Starr1y/FPGA/docs/README.md

# 文档入口

本轮当前文档：[V14接线与操作](V14接线与操作.md)、[三分钟拍摄脚本](三分钟演示拍摄脚本.md)、[任务书对照](任务书对照_20261102.md)、[版本清理与恢复](版本清理与恢复.md)。

原任务依据为[2026-09-23整理稿](任务书_20260923历史整理.md)。其他DUO/FAN/UI23等文档为历史研发记录，保留原文；其旧路径对应清理前标签，不代表当前工作树工程入口。硬件参考、字体许可、用户设计资料保留。
