Starr1y/FPGA/使用说明.md

# 当前版本使用说明

当前唯一FPGA入口是[fpga/current](fpga/current/README.md)，左MPU6050、右BNO085，按钮发声。

请先阅读[V14接线与操作](docs/V14接线与操作.md)，注意**归中后还须从快捷菜单启动演奏**。默认音量8/256，音量80尚待新构建。

历史版本和恢复方法见[清理记录](docs/版本清理与恢复.md)；上位机保留在`host/`。
