Starr1y/FPGA/docs/版本清理与恢复.md

# 版本清理与恢复（2026-11-02）

## 保留与归档原则

- 当前唯一入口：`fpga/current/`，精确归档已交付V14，源码和位流一一对应。没有把待改的默认音量80混入旧位流。
- 保留`experiments/2026-10-29-GEST26-stable/`全部内容，286个文件逐个SHA256核对未变；该基线为历史不同传感器/击发模式，不能当V14插线直接替换。
- 上位机2.7.2 ZIP从旧GEST27发布目录迁到`host/`，Git blob与SHA256不变；保留源代码所在包。
- `docs/`硬件参考、任务依据、CAD/设计资料和第三方许可保留。早期研发文档仍在原位，其源码链接按清理前标签读取。
- 原开发副本、桌面发布目录和本地未提交时序实验未清理；本次仅在独立发布副本中操作。

## 从当前工作树移除的旧内容

共2406个原跟踪路径从旧位置移除（其中上位机ZIP迁移，部分源码在当前工程重新归档）。具体以本次Git diff为准。

| 旧入口 | 原因和去向 |
| --- | --- |
| `fpga/`下旧FAN、DUO01/02/03、IO22、UI23、原始音频/观测组件、旧reports/impl与GEST27 ZIP | 当前工程自带完整依赖，多个旧入口容易误烧；全部原始内容仍在清理前标签，未重写历史 |
| `board-test/`旧版证据 | 旧报告不能当V14证据；V14证据置于`fpga/current/validation`和`reports`，旧证据由标签恢复 |
| `piano-tail-fix-20261008/` | 旧独立迭代归档到历史 |
| 2026-10-17 MOUSE1.4、2026-10-18 LIVE2.0/2.1实验快照 | 重复工程、旧上位机及运行环境不再堆放主工作树；历史可恢复 |

没有强推、删除历史提交或删除远端历史标签。此清理降低当前工作树的混乱，**不会让完整Git历史自动变小**。新电脑只取当前工作树可用浅克隆；需要历史时再fetch相应标签。

## 精确恢复

清理前提交：`e16aaf42515aa47f3d8796b693c2edb623edec7a`。

清理前标签：`archive/pre-v14-cleanup-20261102`。GitHub查看：[完整旧树](https://github.com/Starr1y/FPGA/tree/archive/pre-v14-cleanup-20261102)。

推荐在独立目录克隆该标签，避免覆盖当前工作目录：

```powershell
git clone --branch archive/pre-v14-cleanup-20261102 --single-branch https://github.com/Starr1y/FPGA.git FPGA-before-v14
```

需要某个旧文件时，在该旧树中定位并复制即可；不要在有未提交改动的当前工程上执行整树恢复。原有`gest26-stable-baseline`标签保持原样。

## 本轮验证口径

当前输入/位流/证据的校验工具为`tools/verify_current_release.py`，便携回归入口为`tools/run_current_regressions.py`。新回归结果另存，不覆盖冻结的原始validation。实板声音、方向、双手及量化验收仍按任务对照表推进。
