Starr1y/FPGA/docs/当前任务书执行与验收.md

# 当前任务书执行与验收

更新：2026-10-17。此文按当前 `C:/Users/10324/Desktop/TangLab/TangLab` 核对，不沿用 9 月旧工程的实现状态。

## 范围和用户最新决定

完整目标为双手自主读取、演奏控制、音频合成、本机显示与实机测量。原始任务依据为 [2026-09-23 整理的任务书](任务书_20260923历史整理.md)，其中“现状”是历史记录，不代表当前进度。

用户后续决定优先打通实际 IMU 操控 HDMI，采用 I²C；选音恢复为相对基准方向前方 180°，不循环，取消距离选音。击发改为模块 Z 轴负向线性加速度 **或** 负向急动度。中文界面、英文唱名、按键切换诊断页、宽松归中和手持操作保留。双手、发声及任务书指标继续在完整范围内，当前静音单手 UI 不能作为整机完成证据。

## 工作包审计

### DUO02 与外部控制开发

独立 [DUO02](DUO02_立体声与音效接入.md) 已将 32 Voice 按两手分配到独立左右混音，接入延迟、分数合唱、简化混响和效果后静音渐变。8/32 Voice 加默认混响至实际串行 DAC 的数字检查通过；32 Voice 场景 3034 个采样、6066 个串行字、最大合成 369 周期、无欠载或效果丢样。14 张 RTL 画面、三键模式/湿声与新状态提示检查通过。两路 100 Hz 原生行为传感器、50 MHz/48 kHz 板卡数字链路已通过，解码 83449 个串行字，验证独立归中、负 Z 和弦/旋律、启用混响、静音渐变和停用隔离。首次布线报 PR0004/0 未布通，没有产生时序或位流；保存失败证据后，算法 1 重建成功，setup/hold 零违例，Fmax 50.026/26.542 MHz，Logic 35.8%、BSRAM 74、DSP 83，已冻结本版本。核心余量非常小；没有实物声音/双手/长期负载证据。

[外部控制输入逻辑和参数菜单](外部编码器踏板与腕部按键逻辑.md)已实现编码器 2/4 边沿定位、踏板和两只腕部按钮的同步/消抖/松键事件，接入音色/尾音/效果/湿声/延迟/反馈等参数控制。原始输入到菜单及菜单边界/所有权检查通过。独立中文菜单绘制与 50/25 MHz 帧快照联动通过数字检查、综合为 0 DSP/4 BSRAM；尚未分配板卡引脚或接入主工程 TMDS，不能将数字检查视为物理踏板、编码器和腕部按钮已完成。

### 菜单到音频参数接入

[菜单到实际音频参数接入](菜单到音频参数接入.md)已新增独立核心：单一菜单参数源连接真实合成器、可调音效和 PT8211，复用现有传感器队列握手；音色/尾音只作用于后续音符，效果调参先降低湿声再提交。32 个不同音高同时活动、最大菜单混响反馈/湿声及动态表情的数字检查通过。尚未接入 DUO02 的外部引脚、IMU 和 HDMI 顶层，没有新位流或实物验证。

### DUO03 整机数字验证已冻结

[工程与操作](DUO03_统一控制与菜单接入.md)：板载键、编码器、踏板和腕部按钮共用一份参数，菜单已接入双 IMU、32 Voice、可调立体声和三页显示。KEY0＋KEY1 短按打开菜单。

六项数字/构建检查全部通过，包括原始按键到 RGB、双 I²C 至 PT8211、8/32 Voice 和 13 张 RTL 画面。Logic 35.9%、BSRAM 80、DSP 83，setup/hold 零违例、Fmax 50.861/29.724 MHz。下载文件为 `fpga/bitstream/tanglab_duo03.fs`，清单为 `board-test/duo03/firmware.json`；尚未下载或实物验证。

返回后先按[单手验证顺序](DUO03_返回后单手验证.md)核对启动来源、版本、静音和归中，再测负 Z 击发。[实机延迟工具](实机延迟记录与离线验收.md)和空白模板已提供；七项合成数据检查不代表实测 ≤10 ms。

### 波形、频谱与 Voice 观测开发核心

[FPGA 内音频观测](FPGA音频波形与频谱采集.md)已实现真实 PCM 的 1024 点双声道 FFT、64 列波形极值、64×2 频段及 32 Voice 元数据整帧缓冲。实际 32 Voice/混响/DAC 路径采样核对、两时钟像素读回和过载/复位检查通过。组合组件未布局综合为 Register 2000、LUT 1666、BSRAM 11、MULTALU27X18 2。

**尚未加入当前下载位流或绘制中文观测页**，没有整机新增时序或实物频谱结论。DUO03 保持原哈希，下一步接观测页面和实际 Voice 总线；WS2812、原生多分辨率与实测继续保留在完整任务范围。

### DUO01 板卡集成进度（数字验证已冻结）

已新增独立 `fpga/duo01/` 工程，双 I²C 引脚按 NEO Rev1.4 原理图逐点核对，板端采用开漏输出；接入双手扇区页面、物理按键命名、32 Voice 和 PT8211 数字输出。原 FAN04 源码及冻结位流保持原样。

首轮时序问题已修正：新版 setup/hold 违例为零，核心/像素 Fmax 50.123/27.371 MHz；Logic 48365、Register 21500、BSRAM 40、DSP 71。本版本使用有界音符查表、映射寄存器及力度事件缓冲；2048 个映射向量、8/32 Voice、按键与画面检查通过。50 MHz/48 kHz 原生完整数字链路已通过，两个 100 Hz 行为 IMU 完成独立归中、负 Z 和弦/旋律击发、静音渐变及单手停用隔离；解码 PT8211 的 83449 个串行字，其中 8136 个非零。位流及源码哈希已冻结；未下载或做模拟音频实测。核心时序余量较小，冻结与实板验收分别处理。

[独立双声道音效模块](双声道音效开发与验证.md)已通过旁路、延迟、分数合唱、四抽头混响、33000 个满尺寸 RAM 样本与清除/复位/削波检查；综合确认 32 BSRAM。尚未接入 DUO01，也不代表音效整机验收通过。

| DUO01 新增项 | 已完成的软件 | 当前验收范围 |
| --- | --- | --- |
| 双手板卡适配 | 两路独立 I²C、各自启停/原点/布局/表情，原理图球位与排针追踪 | 两颗模块与板端电气实测待完成 |
| 板端控制 | 物理 KEY1/KEY2 命名修正，组合键释放检测、去抖、当前手操作 | 按键仿真通过，实际操作待验证 |
| 双扇区 UI | 同屏两手、7/5/12 布局、独立击发提示、隐藏诊断、文楷字距 | RTL 模拟画面检查；显示器实拍待验证 |
| DAC 与 32 Voice | 50 MHz 核心、48 kHz 16 位混音复制左右、默认静音、渐入渐出 | 时序门槛和原生完整数字链路通过；没有模拟输出证据 |
| 完整任务 | 新代码保留前方 180° 角度选区及负 Z 加速度 OR 急动度 | 踏板/编码器/腕部键、效果/立体声、教学 LED、量化实测仍待完成 |

| 工作包 | 当前证据 | 仍需完成或验证 |
| --- | --- | --- |
| T0 实板基线 | 已有用户确认的 I²C 在线、姿态和下拍；Gowin C 版器件/时钟/引脚报告。FAN03 数字构建和位流已发布；历史 JTAG 枚举记录 | 新击发版本下载、接线/轴方向照片、模块带载电压；实际音频输出、时钟及外部测点记录。用户确认 IMU 未连接并延后实测；历史 UI 能用不证明新位流已经上板 |
| T1 自主传感器读取 | FPGA I²C 主机、SHTP Set/Get Feature、四元数与加速度/角速度解析，实际时间戳；双手核心隔离检查及 DUO01 双总线板卡适配代码 | 真实两手报告率、丢包、断连与拔掉 PC 后持续运行仍待实测。当前 `AUTONOMOUS_SPI` 为历史参数名，FAN 构建实际调用 I²C 主机 |
| T2 演奏控制 | 每手相对归中、7/5/12 音区、180° 非循环、3° 滞回、越界/陈旧/跳变保护；负 Z 击发、力度、Roll 八度与表情；DUO01 双手 UI/当前手按键代码 | 触发阈值、报告间隔与表情手感需真人验证；踏板、编码器、腕部按键及实际镜像佩戴仍待完成。按键切换和弦模式不代表物理踏板已实现 |
| T3 音频 | 32 Voice、ADSR、四个音色预设、Release、DUO01 板载 PT8211 代码与时序；独立延迟/分数合唱/简化混响模块通过仿真和综合 | DUO02 已接入独立左右混音及三类音效，8/32 Voice 与原生 DAC 数字链路检查通过；外部菜单到真实音频链路的独立数字检查已通过；DUO03 已接板卡顶层并完成数字回归与位流冻结；模拟输出与实板最大负载验收待完成。FAN04 冻结顶层继续保持静音 |
| T4 本机显示与教学 | DUO01 双扇区、7/5/12 布局、独立预选/击发、演奏/诊断两页、帧快照 CDC、640×480 安全区域，8 张 RTL 模拟画面通过 | 独立中文菜单与原始编码器/按钮到 50/25 MHz 帧快照已通过数字验证，DUO03 已完成主工程三页显示接入及 13 张光栅检查；实板双手页面、物理踏板/编码器、真实 PCM 波形/FFT 与 Voice 元数据、像素帧缓冲已完成组件级验证；中文绘制页和整机接入、WS2812 曲目与节拍待完成；显示器缩放不代表原生多分辨率或 EDID 协商 |
| T5 测量与交付 | 独立版本、源码/位流哈希、数字检查、资源与时序报告、中文操作说明 | 每手真人识别率/误触发、10 分钟漂移、1000 次外部动作至模拟音频延迟、32 路谱峰与逐路静音、最大负载 2 小时日志、两手结构接线与完整演示包 |

## 量化目标的证据要求

| 项目 | 完成条件 | 当前状态 |
| --- | --- | --- |
| 七区稳定 | 每区中心 30 秒不跳区；边界往返 20 次无抖动 | 数字边界检查存在；实物原始记录缺失 |
| 漂移 | 固定 10 分钟，相对 Yaw ≤5°或不跨区 | 实物记录缺失 |
| 击发识别 | 每人每手 100 次，识别率 ≥98%；非击打 100 次误触发 ≤2 次 | 仅有数字逻辑测试与用户功能反馈；不能给出真人识别率 |
| 基础复音 | ≥4 独立 Voice 重叠，实际动作/和弦触发 | DUO02 数字混音及串行 DAC 记录已完成；真实动作和模拟输出待测，FAN04 保持静音 |
| 32 Voice | 32 个独立频率与状态，逐路静音 | DUO02 的 32 Voice 数字检查已通过；实板频谱、逐路静音及整机音频验收待完成 |
| 三类表情 | 力度只改音量，Roll 改音高，Pitch 改音色明暗；3～10 Hz 手颤单列 | FAN04 数字检查覆盖 100/200 Hz 滤波与元数据异常保护；真人与声学验证未完成 |
| ≤10 ms 延迟 | ≥1000 次外部动作参考至 DAC 模拟输出，报告全部样本与最大值 | 缺实际动作参考/模拟输出波形；数字仿真次数不能替代 |
| 满负载 2 小时 | 32 Voice＋效果＋HDMI＋双手通信，无欠载/卡死，记录削波/复位 | 整机连续实验缺失 |

## 当前推进顺序

1. FAN03 已将负 Z 加速度/负 Z 急动度做成独立 OR，15 项仿真、34 种 RTL 画面及构建通过；Logic 12.4%，建立/保持违例零。待用户返回后下载并进行真人下拍标定。
2. FAN04 已对齐 100 Hz 报告和滤波，数字检查覆盖 3～10 Hz 手颤、慢 Roll、Pitch，以及松键保持与掉线安全；等待真实 IMU 验证。
3. [双手 I²C 开发核心](双手I2C核心与事件所有权.md)已通过 4 项数字仿真，具备各自归中、表情、事件队列和取消所有权；DUO01 已完成板卡引脚/开漏适配及双手 UI；先验证单颗健康 IMU，再验证真实两手，后续接踏板/编码器/腕部按钮。
4. [双手数字音频核心](双手数字音频集成与验证.md)已接入双 I²C 开发链路，完整音区映射、和弦模式及组释放有数字证据；DUO02 已接入效果与独立立体声并冻结位流；DUO03 已连接外部控制和主工程菜单并完成数字冻结，下一步做实板声音及延迟验收。
5. 保存真实动作/模拟音频测点、全部统计及长时日志，逐项验收后冻结版本。

任何阶段都以当前源码和该版本证据为准。任务书完整目标仍未完成，数字检查或一次成功下拍不能代替双手脱机演奏和全量实机验收。
