Starr1y/FPGA/docs/DUO03_返回后单手验证.md

# DUO03 返回后单手验证

2026-10-17。本表为空白实测计划，尚未执行下载或测试。先只接一颗健康 IMU，右手留空且不使能。

## 先确认上电时会运行哪个程序

SRAM 下载在 FPGA 掉电后会丢失；再次上电可能运行 Flash 中的旧程序。旧 SPI/UART 与本版 I²C 的引脚用途不同。因此，不能按“先 SRAM 下载→整体断电接线→上电”就假定仍在运行 DUO03。

1. IMU 和新增外部信号先保持断开，板卡单独连接电脑。核对下载文件 `fpga/bitstream/tanglab_duo03.fs` 与发布清单，不选临时 `impl/` 文件。
2. 单板 SRAM 下载后核对 HDMI **DUO03**，两手“待使能”、静音。先用板载键验证菜单、诊断和焦点；这一步不接传感器。
3. 在接入模块前，确认冷启动来源：采用经核对的仅 JTAG 启动方式，确保配置前相关引脚状态适合接入；或经明确选择将已验证的本版写入正确启动 Flash，再以模块断开状态冷启动核对。具体模式、开关和 Flash 操作需根据实际板卡与下载器确认。本次没有改启动开关或写入 Flash。
4. 启动来源确认之后才整体断电接线。不要通过带电插拔保持 SRAM 内容。若尚不能确认冷启动程序，先停在单板 UI 检查，回来后再核对启动方式。

手动启停只是已配置逻辑对输出的门控；不是 PGOOD、限流或配置前/掉电隔离。D14/D15/F15 留空，不能用 D15 接 3V3 绕过检测。以下步骤不能消除缺少隔离时电源松动造成的反向供电风险。

## 接一颗模块，保持静音

在已核对的启动条件下，整体断电连接手 0：SCL→E19/J13.38，SDA→C18/J13.40，INT→E16/J13.28，RST→D20/J13.36。VCC 接实际测得的 3.3 V，GND 共地；PS1、PS0、ADO、CS 接模块共地节点，地址 0x4A。J13.11 是 5 V，不能作 3.3 V。具体排针追踪见[DUO01 接线](DUO01_双手板卡接入与操作.md)。

所有组合键都应一起按下、全部松开；上电先松开所有键。短按建议 80～200 ms。第一次只使用板载键，不要求外接按钮。

| 顺序 | 操作与预期 | 实测记录 |
| --- | --- | --- |
| 1 | 上电核对 DUO03、两手未使能、焦点左手、静音；检查模块供电与温升 | 待填写 |
| 2 | KEY1＋KEY2 长按约两秒再全部松开；只启动左手 | 待填写 |
| 3 | KEY1＋KEY2 短按切到诊断；左手 PKT 增长，姿态随转动改变 | 待填写 |
| 4 | 面向演奏正前方，稍稳后短按 KEY0；记录归中耗时及精度，不要求手持绝对静止 | 待填写 |
| 5 | 短按 KEY1＋KEY2 回演奏；左右慢转验证前方 180° 七区和越界保护 | 待填写 |
| 6 | +Z 朝上，沿本体 −Z 下拍一次；观察品红闪光、上次音符和击发数，回位后再拍 | 待填写 |
| 7 | 分别只旋转、向上、慢平移、静止；记录误击发与跳区 | 待填写 |
| 8 | KEY0 长按约 1.5 秒换为 5/12 区；KEY2 短按只切焦点，右手仍未使能 | 待填写 |

击发条件沿用负 Z 去重力加速度 ≤−2.5 m/s² **或**负向急动度 ≤−80 m/s³，另有数据新鲜度、归中、可用音区、回位和防连击门槛。向上动作的减速也可能产生负 Z；按实际波形和误击发记录调整，不能靠动作名称判断。这里的“负 Z”是模块本体轴，不是任意姿态下的房间竖直向下。

## 菜单与声音分开验证

KEY0＋KEY1 短按打开/关闭菜单；菜单内 KEY1 下一项/增加、KEY2 上一项/减少，KEY0 确认/退出编辑，KEY0 长按返回。菜单内不使用单键短按归中或换手；先关菜单再做演奏操作。

| 检查 | 操作与预期 | 记录 |
| --- | --- | --- |
| 参数共用 | 菜单改左手音色，回主页面显示同值；主页面 KEY1 短按后菜单也更新 | 待填写 |
| 显示分层 | 主页面只保留演奏信息；诊断显示姿态/通信；菜单显示请求值、生效音效和过渡状态 | 待填写 |
| 表情 | 主页面 KEY1 按住至少 300 ms，慢 Roll/Pitch，松开结束；菜单打开时不触发表情 | 待填写 |
| 低音量试音 | 以上静音检查通过后，低音量接耳机/输出，KEY0＋KEY2 长按两秒解除静音；左手仅左声道 | 待填写 |
| 新音符参数 | 改音色/尾音后再下拍，新音符采用新值，旧尾音不突然换音色 | 待填写 |
| 音效过渡 | 菜单调音效、延迟、湿声等；观察“过渡中→已生效”，听是否爆音或卡顿 | 待填写 |
| 停用与复位 | 主页面 KEY2 长按约 1.5 秒复位当前手，需重新归中；KEY1＋KEY2 长按启停 | 待填写 |

六个外部输入可继续留空。准备测试编码器/踏板/腕部键时，按[DUO03 输入表](DUO03_统一控制与菜单接入.md)断电连接无源触点，共地 J13.12，不能输入 5 V。双手和模拟音频延迟、识别率、漂移、两小时负载另行验收；参见[任务审计](当前任务书执行与验收.md)与[延迟记录](实机延迟记录与离线验收.md)。
