Starr1y/FPGA/docs/任务书_20260923历史整理.md

# 凌空双奏：FPGA 双手姿态感知虚拟乐器任务书

**整理日期：**2026-09-23  
**目标依据：**《基于FPGA的双手姿态感知虚拟乐器_技术评审与任务材料清单(1).docx》（V1.0，2026-09-13）  
**现状依据：**桌面 `C:\Users\10324\Desktop\TangLab_test\TangLab` 中的 RTL、测试平台、Gowin 报告、固件清单及交付记录。  
**状态口径：**“已实现”指当前源码存在相应逻辑；“仿真记录”指项目交付文档记载通过，但本次未重新运行仿真；“已生成位流”指目录中有原编译结果；“上板通过”必须有本轮实物数据。目标文档中的设计与指标均不自动算作已完成。

## 1. 项目目标与范围

制作一套以 **Tang Mega 138K 普通 Dock C 版**为实时主机的双手虚拟乐器。两只手的 BNO085 直接接入 FPGA：相对 Yaw 选择七音区，下拍触发音符，动作强度控制音量，Roll 控制击发八度、持续弯音和手颤，Pitch 控制音色明暗。踏板在“双旋律”和“左手和弦＋右手旋律”之间切换；旋转编码器在板上设置音色、尾音和效果。声音由 FPGA 逐样本合成并经 I²S 输出，HDMI/LED 显示演奏状态；PC 仅用于调试和记录，不参与正式演奏的实时闭环。

**基础验收目标：**双手交互、至少四个独立 Voice、ADSR 与混音、实时变调、无整段预录 PCM、动作到模拟音频输出的最大延迟 ≤10 ms（最终至少 1000 次）。  
**主要拓展目标：**32 个独立 Voice、力度/Roll/Pitch 三类可独立展示的声音表情、两类合成音色、FPGA 内音效、HDMI 视听反馈和脱机 LED 教学。≤5 ms、ESP-NOW、BLE/手机、录音回传是通过核心验收后再决定的冲刺项。

### 系统边界

- BNO085 可承担芯片内部采样与姿态融合；FPGA 负责 SHTP 报告处理、相对姿态、动作判定、Voice 调度、声音、效果和显示。不能把 BNO085 内部融合说成“全部由 FPGA 实现”。
- 有线正式演奏不依赖外置 MCU 或 PC。无线附件如实施，应与核心路径隔离。
- 所有“≤10 ms”“32 复音”等完成声明都需要对应的可重复实测或仿真证据；Gowin 时序报告只证明约束内的数字路径，不能代替整机延迟测量。

## 2. 工作包与完成定义

| 编号 | 工作包 | 主要工作 | 可交付成果与通过条件 |
| --- | --- | --- | --- |
| T0 | 实板基线 | 核对 C 版器件、50 MHz 时钟、3.3 V 接线；下载现有位流；验证串口握手、单/四声部 I²S 音频和单颗 BNO085 SPI | 固件版本与 SHA-256、接线照片、逻辑分析仪或示波器记录、实测问题清单；模拟结果单列 |
| T1 | 传感器自主读取 | 由 FPGA 完成 BNO085 复位、SHTP 初始化、Set/Get Feature、长度/通道/序号检查和四元数/加速度/角速度定点解析；再扩为双独立 SPI | 不借 PC 下发每次配置即可持续取得双手有效报告；记录报告率、丢包、错误和恢复状态 |
| T2 | 双手演奏控制 | 每手相对原点、七音区和滞回、下拍状态机、力度、Roll 八度锁存/弯音/手颤、Pitch 明暗、掉线安全；踏板与编码器去抖 | 断开 PC 后双手可选音、击发、切换模式与参数；单变量实验可分别证明三个声音表情 |
| T3 | 音频扩展 | 保留现有四 Voice DDS/ADSR 基础，加入 Note-On/组所有权/回收、和弦与 32 Voice；增加第二类 FM 或等价独立音色、可调 Release、延迟/合唱/简化混响 | 四 Voice 正常重叠；32 个独立频率与状态可逐路检查；最大负载无欠载、卡死或异常削波 |
| T4 | 本机显示与教学 | FPGA HDMI 显示音区、左右手、踏板模式、参数菜单、Voice、波形与频谱；WS2812 教学提示 | 拔掉 PC 后仍能演奏和设置；画面及 LED 与真实声音/状态一致 |
| T5 | 测量与交付 | 外部动作参考到 DAC 模拟输出的延迟测量；漂移、误触发、复音、断连及长时间运行；整理可复现交付包 | 保存原始数据、测点、统计、工具版本、稳定码流、演示脚本及开源引用记录 |

**依赖顺序：**T0 的实板基线 → T1 单手自主读取 → T2 单手最小演奏闭环 → T1/T2 双手扩展 → T3/T4 增强 → T5 全量验收。T3 中现有四 Voice 可与 T1 并行维护，但不能以 PC 手动配置四 Voice 代替“脱机姿态演奏”。

### 建议里程碑

原目标文档按两名队员、每人每周约 15～20 小时、八周实施作规划。下表是**从正式启动日重新计时的目标**，不是当前已完成周次。

| 阶段 | 里程碑 | 进入下一阶段的门槛 |
| --- | --- | --- |
| 第 1～2 周 | 单颗 BNO085 自主读取、实板音频、单手七区与下拍、四 Voice 最小闭环 | PC 断开后可由单手动作发声；报告率、丢包、初步延迟有实测记录 |
| 第 3～4 周 | 双 SPI 双手、踏板模式、力度/Roll/Pitch 表情、32 Voice 与两类音色 | 双手不串音；旧 Voice 在踏板切换时不跳音；三表情可分别展示；32 路有独立证据 |
| 第 5～6 周 | FPGA 效果、HDMI 菜单/波形/频谱、LED 教学；视核心进度决定无线/手机 | 完整原型脱离 PC 可演奏；效果和显示不引起音频欠载 |
| 第 7～8 周 | 1000 次延迟与动作统计、最大负载和 2 小时稳定运行、版本冻结、演示与复现资料 | 只演示有证据的稳定功能；冻结后变更须重做相关回归 |

## 3. 关键量化验收

| 项目 | 目标文档给出的验收条件 | 当前是否已有证据 |
| --- | --- | --- |
| 单手七音区 | 每区中心 30 秒不跳区，边界往返 20 次无抖动 | 无实物数据 |
| 姿态长期稳定 | 固定 10 分钟，相对 Yaw ≤5°或始终不跨区 | 无实物数据 |
| 下拍识别 | 每人每手 100 次，识别率 ≥98%；非击打共 100 次，误触发 ≤2 次 | 尚无动作识别 RTL |
| 基础复音 | ≥4 个独立 Voice 同时发声，正常双手/和弦演奏可触发 | 四 Voice 音频 RTL 与仿真记录有；姿态演奏未完成 |
| 拓展复音 | 32 个独立 Voice，32 个不同频率，可逐路静音并核对状态 | 尚无 32 Voice RTL |
| 三维表情 | 力度只改音量、慢 Roll 改持续音高、Pitch 改频谱明暗；手颤 3～10 Hz 单列验证 | 尚无对应动作和表达链路 |
| 有线端到端延迟 | 外部动作参考至 DAC 模拟输出，最终 ≥1000 次，最大值 ≤10 ms；异常样本不得删去 | 尚无整机测量 |
| 最大负载和稳定性 | 32 Voice＋效果＋HDMI＋通信无欠载；完整运行 2 小时 | 尚无整机测量 |

“≤5 ms”仅在同一完整方法的 1000 次最大值通过后申报。以上阈值来自目标文档，具体赛题口径仍需按正式竞赛文件核实。

## 4. 桌面 Gowin 工程目前完成了什么

### 4.1 已有源码与构建结果

| 子系统 | 当前可确认的实现 | 证据及边界 |
| --- | --- | --- |
| Gowin 工程 | `fpga/tanglab.gprj`、RTL、CST/SDC、`build.tcl` 齐全；目标器件 `GW5AST-LV138PG484AC1/I0` | 原 PnR 报告记录 Gowin **V1.9.12.03**、器件 C 版；这是 2026-09-21 的已有构建，本次未重新编译 |
| 位流与资源 | `fpga/bitstream/tanglab.fs` 已生成，SHA-256 为 `a017322bc3e3911c5d783eeaee1d2da0972148459151aa4514f112e2a067cbdf`；报告记录 9 BSRAM、3 DSP、Fmax 57.204 MHz | SHA-256 与 `board-test/固件清单.json` 一致；内部 50 MHz 时序报告不能说明板外接口或实板性能 |
| 四声部音频 | `audio_core.v` 有四套相位/频率/增益/ADSR 状态、正弦/锯齿/方波/三角波、饱和混音和削波计数；`i2s_output` 输出 16 位双声道同一混音，平均 48 kHz | `tb_audio.sv` 覆盖饱和、释音、I²S 移位；`docs/交付验证.txt` 记录仿真通过。尚无 32 Voice、FM、效果、立体声独立处理 |
| PC 串口与抓取 | `top.v` 连接 921600 baud UART、帧收发、配置命令、2048 点×5 通道抓取、预览与状态计数；`docs/协议与测量.md` 描述 CRC 和测量口径 | `tb_lab.sv` 与交付记录记载四声部 375/750/1125/1500 Hz 数字链路验证；本次未取得并重跑原始仿真日志 |
| IMU 传输 | `imu_transport.v` 可选择 RVC UART、SHTP UART 或单路 SPI Mode 3；实现复位/WAKE/CS/INT、原始包缓冲、长度限制、时间戳和错误计数 | `tb_imu.sv` 覆盖三种输入与 SPI 发送；这是**单个可切换传输端口**，不是双颗 BNO085 并行读取 |
| 上板准备 | 有 PMOD 接线指南、SPI 参数 JSON、固件清单及原编译报告 | `board-test/two-voice-spi.json` 的 1000 报告是**测试目标参数**，不是完成的测试结果 |

### 4.2 尚不能算完成的目标

1. **传感器自主控制与双手：**当前 `imu_transport.v` 注释明确写着“Report decoding and feature requests are on the PC”。RTL 未见 FPGA 内 SHTP 传感器报告解析、自动 Set/Get Feature、双独立 SPI、相对四元数或精度监控。
2. **姿态直接演奏：**未见 Yaw 七音区、归中/滞回、下拍判定、力度映射、Roll/Pitch 表情、声部组和弦、踏板或编码器输入。当前 Voice 主要通过 PC 串口命令配置，不能据此称为脱机双手乐器。
3. **拓展音视频：**未见 32 Voice、FM 引擎、延迟/合唱/混响、HDMI、WS2812 教学。PC 上的音频图表不能替代 FPGA 直出 HDMI。
4. **硬件验收：**目录中的 `docs/交付验证.txt` 与 `board-test/固件清单.json` 均明确记载实板音频/SPI、1000 条报告和端到端延迟未验证；也没有两手误触发、漂移或 2 小时运行数据。
5. **PC 软件范围：**交付记录提到 TangLab.exe 的模拟联调，但当前桌面 `TangLab` 文件夹不含 EXE 或 PC 源码，无法仅凭这个 Gowin 工程复现 GUI 结论。

**现阶段判断：**项目已完成“可构建的四声部数字音频＋单路 IMU 原始传输＋串口观测”技术底座，尚未形成目标文档要求的“BNO085 双手直连 FPGA、无需 PC 的姿态演奏闭环”。“已生成位流”与“实物已通过”必须分别陈述。

## 5. 下一轮优先任务与停止线

1. **先做现有固件的实板基线。**按项目指南核对板卡 C 版、时钟和引脚，先验证串口握手、声音输出，再验证单颗 BNO085 SPI；保存实际日志、听音结论和示波器/逻辑分析仪证据。任何失败先定位供电、时钟、引脚、协议与位流匹配。
2. **把 IMU 解析与配置从 PC 移入 FPGA。**先完成单颗 BNO085 的初始化、报告解析、报告率和异常恢复，再考虑复制为第二路；以“PC 断开后仍连续产生有效姿态/加速度缓存”为门槛。
3. **建立最小姿态发声闭环。**先用单手七音区＋下拍触发已有四 Voice，验证归中、滞回、误触发和数字注入至 I²S；之后增加第二手、踏板和表达控制。
4. **再扩大到 32 Voice 与显示效果。**每次扩展均保存独立谱峰、资源/时序和音频负载证据；音频稳定性优先于视觉效果、无线和手机功能。

**停止线：**若单颗 BNO085 无法稳定输出所需报告、长线 SPI 持续丢包、板级音频/时钟未确认，或数字注入到 DAC 路径不可测，就先修这些问题，不开始外壳、无线和手机功能。

## 6. 最终交付清单

- 完整 HDL、约束、构建脚本、工具版本、仿真向量、稳定位流、资源与时序报告。
- 两手接线与结构图、SHTP 子集/错误处理说明、踏板与编码器状态图、参数表。
- 延迟原始波形与统计、漂移/识别率/误触发/复音/最大负载/断连/2 小时运行报告。
- 脱机演奏操作说明、五分钟现场演示脚本、答辩材料和故障处理卡。
- 外部参考资料和实际复用文件的许可证/修改记录。

## 7. 证据索引

- 目标任务及指标：随附 Word 文档第 1～44 节，尤其第 26～27 节赛题对照、第 37～41 节排期与量化验收。
- 当前 RTL：`C:\Users\10324\Desktop\TangLab_test\TangLab\fpga\rtl\audio_core.v`、`imu_transport.v`、`top.v`；仿真平台在 `fpga\tb\`。
- 当前构建：`fpga\reports\pnr\tanglab.rpt.txt`、`tanglab_tr_content.html`、`board-test\固件清单.json`。
- 当前验证口径：`docs\交付验证.txt`、`docs\协议与测量.md`、`两声部与SPI上板测试指南.txt`。
