Starr1y/FPGA/fpga/releases/2026-11-04-mpu33-host335/project/duo04-key30-linkfix331/验证记录.md

实际验证（非实物）
tb_linkfix331: TB_PASS old75 periodic reset reproduced,new75 200Hz>1s stable,no timeout widening,bus failure retained,68 DATA_RDY timeout retained
tb_who75_33: TB_PASS all256 identity values:68/75 accepted,other254 rejected
tb_linkfix331_pins: TB_PASS real I2C START/repeatedSTART/ACK14bytes:WHO75 noDRDY+68 standard,200Hz schedule,bus disconnect isolation,failure register capture
GUI故障6/寄存器/自动复位计数可见，最终EXE本地模拟AI、PDF、外部JSON及模拟曲谱上传通过。
身份枚举256项，68/75允许，其他254项拒绝。WHO75无DATA_RDY模型对照旧版周期复位，新版持续200Hz；WHO68正常采样及断流保护通过。真实I2C引脚级双模块、断开隔离和故障寄存器锁存通过。
总线引擎、融合、音色、演奏与显示源码逐字节保持3.3；本轮仅采样调度、设备后缀和故障上下文修改。
未综合布线烧录，未使用真实设备。
