Starr1y/FPGA/host/README.md

# TangLab上位机2.7.2

本包从清理前仓库`fpga/GEST27-routefix2-20261031/TangLab-2.7.2-Windows-x64.zip`原样迁移，没有重新打包或替换用户配置。

SHA256：`1389024f1d3fef7bd8fda3f9e4fd1c77a2a3cfe18b47f0dff2256f65407ec7fa`。Git blob仍为`83d8dcaddff8799d55567d013ce55d80ff46478e`。

包内含Windows便携程序和源码；按包内README启动，AI识别API密钥在本机配置，不写入仓库。此为已有2.7.2版本，不宣称已完整支持V14新增MPU诊断字段或已完成图片到实板教学验收。

演奏闭环不需要上位机；首版图片简谱转换和导入允许电脑参与。当前FPGA见[工程入口](../fpga/current/README.md)。
