Starr1y/FPGA/fpga/current/README.md

# V14：MPU Y轴指向选区（冻结发布）

本目录为已交付 V14 的源码和位流归档，未修改默认音量或传感器类型；左 MPU6050、右 BNO085，两个外接低有效按钮各自发声。

## 构建与文件

打开 `tanglab_duo04_score27_routefix2.gprj`；顶层 `top_duo04`。Gowin **V1.9.12.03**，器件 **GW5AST-LV138PG484AC1/I0 / GW5AST-138C**。在本目录执行 `gw_sh build_selected.tcl`，实际调用冻结的 `build_yforward_v14.tcl`，Route2、timing-driven，保持原CST/SDC。

`INPUT_MANIFEST.json`保留构建当时的输入哈希；其中少量旧名字的脚本/测试是冻结输入，正常构建只使用上述入口。不要为了清理名称修改冻结输入。重建会产生新的impl；Gowin授权与安装需本机配置，不分发许可证。

发布位流：`bitstream/MPU_LEFT_YFORWARD_V14_TIMING_PASS.fs`。

SHA256：`8ba0470c1df1ac357156439d23122be474c355b1ec2593f43e918f5ec9bfebdb`。

完整构建耗时1687.234秒；Setup +0.029ns、Hold +0.164ns、0违规端点、0未布通网络。PR1014告警保留，余量小，不据此宣称任意环境稳定。

原始报告从`impl/`映射到`reports/`；原始`.vg`压缩保存于`reports/synthesis-netlist.zip`，不分发巨大中间布局数据库。原始证据JSON中的绝对路径是历史构建位置，不是当前电脑的依赖。`RELEASE_MANIFEST.json`标明归档文件和路径映射，根目录验证工具核对哈希及关键证据。

## 功能边界

- 左路以MPU物理+Y轴的水平指向选音；当前竖装定义为+X近似向上。Y轴朝天/朝地时水平航向无定义。
- KEY0会重新执行现有零偏/姿态归中，完成后的第一帧水平朝向为零点，应对应FA。需要转180°是待查异常，操作不应要求半圈反转。
- 七音区每区约25.714°，FA名义边界±12.875°，不是20°一音；5/12音布局按原代码保留。
- MPU无磁力计，水平航向仍可能漂移；本模块WHO=0x75兼容为已验证寄存器和采样行为的实验兼容，不声明芯片身份或绝对精度。
- 按钮10ms消抖，一次按下一次击发；运动不发声。必须在线、归中、数据新鲜且角度在有效范围内，整机还须启动演奏。
- 默认音量8/256，用户要求的默认80是下一版待办；不能把改后的源码配给此旧位流。
- 显示1024×600，像素49MHz，H总1312（48/96/144），V总624（3/10/11），约59.85186Hz，负极性同步；逻辑UI640×480映射并旋转180°。
- 右路仍为BNO085；双MPU不是本版配置。声音、方向、实际双手及长时间运行尚未完成本轮验收。

操作及完整排查见[接线指南](../../docs/V14接线与操作.md)。
