Starr1y/FPGA/fpga/releases/2026-11-04-mpu33-host335/project/duo04-key30-linkfix331/README.md

TangLab 3.3.1 周期性采集掉线修复

本版独立于原3.3工程。保留3.3两档轻重音、S1/S2、V14风格HDMI、四音色、32复音、和弦、波形和AI曲谱教学；不使用V14双手采集后端或Lite裁剪。

修复内容：WHO_AM_I=0x75的实验兼容模式按配置的200Hz定时读取原始寄存器，不依赖可能不兼容的DATA_RDY位；WHO=0x68保持原标准状态位轮询。40ms采集保护、I2C错误处理和严格配置读回不放宽。其余身份值仍拒绝。0x75并不证明模块型号，量程/数据布局仍须实物确认。
时间戳仍表示FPGA读出/计算完成时刻，不证明传感器内部数据一定新鲜；无DATA_RDY兼容读取无法仅靠相同数值判断传感器是否停止更新。真实IMU波形与运动需要上板核验。
最近故障寄存器已锁存，重新初始化不会覆盖。上位机演奏页每手直接显示采集在线/离线、故障码、寄存器、I2C错误数、自动复位次数和姿态年龄。

接线沿用3.3（不接INT）：
左SCL J13.38/E19，SDA J13.40/C18，S1 J13.25/D15，S2 J13.28/E16。
右SCL J13.37/D19，SDA J13.39/C19，S1 J13.26/D14，S2 J13.31/E17。
两颗GY-521分别接独立I2C，AD0均GND，XDA/XCL/INT不接。按键另一端接GND；模块/总线使用核实兼容的3.3V供电和逻辑，共地。

编译：打开tanglab_duo04_key30_linkfix331.gprj，顶层top_duo04。必须重新综合，然后重新布局布线；旧fs不含修复。impl中的process_config.json是必要IDE配置。核心50MHz、音频48kHz不变。
本轮没有运行综合、布局布线或下载，没有新的fs。上位机设备名应带L331。只有软件更换不改变板上采集。

测试步骤：
1. 重新编译并检查新报告，下载新fs后打开本目录TangLab.exe连接实际串口。
2. 先输出静音，切换手柄来源；保持静止，等偏置/归中准备，再对已连接手归中。不要求两手同时在线。
3. 连续观察至少60秒：采集是否仍循环离线，自动复位和I2C错误是否持续增加。归中移动前先静止，之后缓慢转动确认角度实际变化。
4. 若仍掉线，记录两次故障间隔、故障码、寄存器、复位/I2C计数、正在使用的fs文件名。码2表示总线事务失败，4身份拒绝，5配置读回不一致，6采样超时。最近故障可保留历史，需结合当前在线状态和计数是否增加判断。
5. 之后低音量试S1/S2、和弦与波形，确认运动确实被更新，不能仅以“在线”判定采集正确。

已知时序限制：原3.3报告有238个setup违例端点、hold违例0，最差-4.292ns路径位于显示状态跨时钟域。本修复没有更改/放宽约束，也没有宣称解决该时序问题；必须用新报告重新检查零未布通、setup/hold及PR1014。
本次只在DATA_RDY不兼容的模型下复现了旧版周期复位，不是已取得实物掉线原因。若新版仍不稳定，应按新诊断定位总线、配置、数据更新或时序问题，不继续盲目放宽超时。
