Starr1y/FPGA/docs/任务书对照_20261102.md

# 任务书对照与未完成项（2026-11-02，V14）

## 对照依据及判定方式

依据仓库[2026-09-23任务书整理稿](任务书_20260923历史整理.md)及其引用的V1.0技术评审任务材料。原始Word原件本轮未找到，因此这是对现有整理稿的逐项技术核查，不宣称已核对新的正式竞赛文件。

历史[执行与验收](当前任务书执行与验收.md)更新于10月17日，含过时的源码现状；其“尚无32Voice”等旧结论不能直接套用V14。这里以V14源码、冻结仿真、完整PNR/STA与本次用户反馈分别判定。未重新运行的历史测试会标明。

用户后续变更：接口改I²C；左传感器改MPU6050、右仍BNO085；IMU只选音，外接按钮击发；显示1024×600；图片简谱教学首版允许电脑参与、无需板端Flash存谱。原任务中的SPI、动作击发、力度、完全脱机教学不能因此直接算通过，需作为变更/降级向验收方说明。

## T0～T5逐项状态

| 工作包 | 当前可确认 | 尚未完成/需补证据 |
| --- | --- | --- |
| T0 实板基线 | V14完整工程/位流、哈希、Gowin版本、引脚、完整STA；用户报告左MPU可在线、可归中，按钮接地故障修复且可拉低 | **模拟声音闭环未确认，当前仍报告无声**；实际下载文件与运行状态留证、接线照片、串口诊断、示波器/逻辑分析仪波形 |
| T1 自主传感器 | FPGA直连左MPU原始六轴→定点融合；右BNO自主初始化/报告路径保留；引脚级MPU仿真通过，异常恢复有数字测试 | 左MPU+右BNO实际同时工作/各自拔插恢复未形成记录；报告率/错误率、10分钟/2小时数据缺失；WHO=0x75兼容不能证明芯片身份；**当前不是双MPU** |
| T2 选音与演奏控制 | 相对方向、7/5/12区、3°滞回、30ms确认；外接按钮10ms消抖和单次击发，掉线/过期禁止；方向与按钮仿真通过 | **用户仍反馈归中后需转180°、SOL/LA区域体感偏窄**；按钮低电平到真实声音尚未打通；双手不串音和手持误触发待测。当前按钮力度固定96，原任务的动作力度表达未实现为本版交互；物理踏板输入顶层接常量，不能称踏板已接入 |
| T3 合成与音频 | 32Voice架构、ADSR、四音色、独立左右混音、延迟/合唱/混响、板载PT8211与标准I²S路径保留 | 当前V14板载/外接DAC实际发声、至少4Voice叠奏、32个独立谱峰/逐路静音、音效和最大负载无欠载均缺实板证明；旧数字记录不是本轮完整32声部验收 |
| T4 HDMI与教学 | 实际工程为1024×600、49MHz、约59.852Hz，UI旋转180°；菜单/归中诊断/逐音等待教学及RAM曲谱存储存在；原上位机2.7.2包含AI曲谱功能 | 屏幕持续无闪烁、朝向/字体可读性尚缺最终验收；图片→识别→人工校对→导入→跟弹全链路未留本轮记录；**WS2812教学未接入当前顶层**；当前HDMI顶层未接入完整实时PCM波形/FFT/Voice观测页；无EDID自动协商/多分辨率选择 |
| T5 测量与交付 | 已有冻结源码/位流/报告/测试哈希；本次补三分钟脚本、接线说明、版本恢复和任务对照 | 真人选区/漂移、1000次端到端延迟、≥4/32复音、双手断线恢复、2小时负载、最终演示原片与完整接线照片均待完成 |

## 指标是否已达标

| 指标 | 要求 | V14结论 |
| --- | --- | --- |
| 七区稳定 | 每区中心30秒不跳；边界往返20次 | 未实测；每区名义约25.714°，不是20°，须先排查方向与估算误差 |
| 长期漂移 | 固定10分钟，Yaw≤5°或不跨区 | 未实测；MPU无磁力计，不能承诺航向长期无漂移 |
| 原动作识别 | 每人每手100次≥98%，非击打100次误触≤2 | 当前交互改为按钮，不具备原动作击发验收证据；应申请变更或后续恢复单独实现 |
| 按钮可靠性 | 按一次一个事件、按住不连发、松开重置 | 数字测试已覆盖；实板建议每手100次并记录漏发/多发，不冒充原动作指标 |
| 基础复音 | ≥4独立Voice重叠 | 架构具备，实板待验证 |
| 32Voice | 32不同频率、独立状态、逐路静音 | 历史数字证据存在；V14完整实板证据缺失 |
| 三类表情 | 力度、Roll持续音高、Pitch明暗；3～10Hz颤音 | 代码有部分映射/效果；本版按钮固定力度，完整三类未实测，不算通过 |
| 端到端延迟 | 外部动作参考→DAC模拟输出，≥1000次最大≤10ms | 未实测。按钮路径自身10ms消抖，还叠加按键板RC及音频延迟；若以物理按下计时，存在超过10ms目标的风险，不能用50MHz STA证明达标 |
| 2小时满载 | 双通信+32Voice+效果+HDMI无欠载/卡死 | 未执行连续实板实验 |
| 教学 | 原文包括脱机LED教学；后续首版为PC参与图片简谱跟弹 | RAM导入/逐音教学有代码；端到端实板待验收，WS2812/断电保谱不是本版完成项；后者已被用户移出首版范围 |

## 当前优先级

1. **先闭环声音**：确认快捷菜单启动→按键事件计数→Voice活动→非零PCM→DAC/耳机输出。当前低电平与音量调整不足以证明事件已到音频。
2. **修方向与区域手感**：记录归中前后Y轴方向、原始/过滤Yaw、选区和校准状态；先复现180°问题，再核查角度缩放/安装轴定义。不能简单整体加180°掩盖。
3. **完成默认音量80的新构建**：当前归档V14默认8；源码、位流、哈希和STA必须作为一个新版本更新，不能只改README称已完成。
4. **下一版双手MPU**：用户已确认下一版改为左/右均MPU6050，并将默认音量设为80。需重新配置、编译和验证两路独立归中、选音、按钮与掉线隔离；本次上传的V14仍是左MPU+右BNO，不使用旧位流冒充双MPU。
5. **可拍演示及教学**：声音/方向过关后，完成两音色、短句、逐音教学，再按三分钟脚本拍摄；AI转换先核对结果再导入。
6. **量化验收**：七区/漂移→≥4Voice→32Voice/音效→1000次延迟→2小时满载，保留全部原始数据。原10ms目标需先确认是否接受按钮模式及其计时起点，必要时优化消抖并重做回归。

## 本次交付边界

本次归档保持V14冻结功能，没有新增双MPU、音量80、动作击发、无漂移或“已修复无声”的声明。上传和仓库清理不是新硬件验收。清理前冻结成果可从标签恢复，详见[版本清理与恢复](版本清理与恢复.md)。
