Starr1y/FPGA/docs/DUO01_单手返回测试表.md

# DUO01 单手返回测试表

本表用于新版通过构建发布门槛之后的实板验证。现在还没有执行这些测试；不要把表中的预期现象当作实测结果。

## 准备

单颗健康模块按 [DUO01 接线表](DUO01_双手板卡接入与操作.md)接手 0。先确认冻结清单和下载文件，HDMI 标记应为 DUO01。上电选左手、左右 IMU 未使能、静音；右手本轮保持未使能。

## 功能顺序

| 步骤 | 操作 | 预期现象 | 实测记录 |
| --- | --- | --- | --- |
| 1 | 左手焦点下长按 KEY1＋KEY2 两秒，全部松开 | 左手开始初始化并在线；右手不启动，声音静音 | 待填写 |
| 2 | 短按 KEY1＋KEY2，再全部松开 | 打开诊断页；左手 PKT 增长，姿态随转动变化 | 待填写 |
| 3 | 面向中间，尽量静止，短按 KEY0 并松开 | 归中结束，偏航接近零，精度满足击发要求 | 待填写 |
| 4 | 返回演奏页，缓慢水平转向左/右 | 青色预选依次变化，七音为 DO RE MI FA SOL LA SI | 待填写 |
| 5 | 转到前方 180° 之外，再回到中间 | 越界时禁止击发；回到范围并静稳后恢复 | 待填写 |
| 6 | 保持朝向，在当前音区做一次模块负 Z 下拍 | 对应扇区短暂品红，上次音符及击发数更新 | 待填写 |
| 7 | 只缓慢转腕、停住或向上抬起 | 不应仅靠转腕触发；向上动作的减速阶段仍可能有负 Z 加速度，需记录动作波形再判断 | 待填写 |
| 8 | 长按 KEY0 ≥1.5 秒再松开 | 七音→五音→十二半音；布局改变不保留旧击发闪光 | 待填写 |
| 9 | 按住 KEY1 ≥300 ms，慢 Roll/Pitch，松开 | 表情状态变化；松开保持弯音/明亮度，颤音停止 | 待填写 |
| 10 | 短按 KEY2 切到右手，再切回 | 只改变当前控制焦点；左手在线和原点不被清除 | 待填写 |
| 11 | 左手焦点下长按 KEY2 ≥1.5 秒再松开 | 只复位左手、需重新归中；不遗留品红击发提示 | 待填写 |

基准方向对应 FA 的七音中心；七区中心约为 −77.1°、−51.4°、−25.7°、0°、25.7°、51.4°、77.1°。边界有约 3° 滞回，跨边界后要再转一点才换区。前方范围以按 KEY0 时的方向为准。

击发检测使用去重力后的模块自身 Z 轴：`az ≤ −2.5 m/s²` 或 `jz ≤ −80 m/s³`，不是任意动作有加速度就触发。每次下拍后回到静稳状态再做下一次，至少留出 100 ms 防连击时间。模块装反或倾斜时，本体 −Z 与房间向下可能不同。

## 发声测试另行进行

以上静音 UI 验证通过后，再使用 KEY0＋KEY2 长按两秒切换发声；先低音量验证耳机/板载音频输出。软件默认 16 位混音复制左右，四个音色按 KEY1 短按切换。数字串行输出通过不等于模拟声音已经正常。

诊断页通信计数与 HZ 为十六进制，HIT 为十进制。记录固件哈希、接线照片、各步画面、异常动作及声音现象；完整任务书中的真人识别率、十分钟漂移和端到端延迟应另建原始数据记录。
