Starr1y/FPGA/fpga/releases/2026-11-04-mpu33-host335/host/数字教学使用说明.txt

TangLab 3.3.5 上传曲目数字教学

1. 关闭旧上位机，运行本目录TangLab.exe。连接原33/3.3.1固件；本版不需要重新烧录。
2. 第04页导入/AI转换→检查转换格式→上传；使用七音布局。含半音的十二音曲目不能用本次数字段映射，不会静默替换音符。
3. 下方先点停止；来源选择“键盘数字／鼠标教学测试”；点“选择导入曲目与来源（先停止）”；再点开始。
4. 点页面空白处，移开下拉框/输入框焦点，开启Num Lock。根据板上目标按数字：
   主键盘顶行1～7：左手DO RE MI FA SOL LA SI。
   数字小键盘1～7：右手DO RE MI FA SOL LA SI。
5. 数字直接选音并作答，不需要移动鼠标或再按S1。鼠标点击扇区仍可作答，走相同板上判题链路。
6. 弹对绿闪后等下一目标，再重新按数字。按错或错手仍送板卡判错，不由电脑代判。按住不连发，反馈期间不提前缓存下一题。
7. 暂停/继续保留进度；重来回第一题；停止结束教学。完成后不自动循环。

教学页数字自动启用，不依赖第01页“开启键盘演奏”或演奏模式选择。仅活动的第04页、电脑教学来源、正在运行的已上传曲目生效；编辑框打字/Ctrl快捷键不发音，暂停/停止/完成/真实IMU来源不发音。
教学自动使用目标音的C档，不按W/S换档，也不使用A/K表情或和弦。教学只支持逐音作答，不评节拍。
原第01页鼠标/数字两种演奏模式、纯轻音处理及W/S右手升降档保留。
该数字教学当前面向七音曲目；如果是五音/十二音布局，会明确提示使用七音。

验证：原演奏映射、教学双手1～7、Num Lock修饰符区分、按住不连发、暂停/反馈/在途判题/编辑焦点保护，以及最终EXE离线测试通过。协议检查确认使用原鼠标短按命令并等待板上计数变化，拒绝过期目标；真实板卡教学推进与声音待实测。
AI配置/曲谱协议及固件未改。本包无API密钥、用户曲库或会话令牌。
