Starr1y/FPGA/fpga/releases/2026-11-04-mpu33-host335/project/duo04-key30-linkfix331/协议变更.md

# KEY30协议增量
Hello载荷55字节，设备名DUO04-LIVE 2.1+GEST27+MPU6050+LITE29+KEY30。
虚拟输入继续使用76：手u8、S1/S2位掩码u8、Q4俯仰i16、保留u8。仅电脑来源有效，鼠标教学也走此输入；50直接击发返回不支持，避免绕过按键判定。
75表情配置仍为滑音左右掩码u8、颤音左右掩码u8、滑音ms u16。15/16/17/18本地菜单分别控制左右颤音/滑音。
真实/虚拟S1复用32位事件，kind=0起音、kind=1力度更新；力度仅改最新击发组且匹配事件ID/epoch。S2组合控制是否消费成连奏。
状态136保持496字节；原手势debug区每手7字节little-endian，bits55:52阻断码，51:44力度，43:42按键掩码，41长按，40组合，15:0音高偏移。0阻断=正常，1姿态/在线无效，2音区无效。事件140上传S1计数，不再上传加速度敲击作为发音事件。
整体采样、曲谱上传CRC协议不变。旧GUI只能读取部分兼容字段，新交互必须使用3.0。
