Starr1y/FPGA/fpga/releases/2026-11-04-mpu33-host335/host/source/score_assets/曲谱格式规范.md

# TangScore v1 曲谱格式

使用UTF-8的`.tangscore.json`，JSON Schema见同目录`tangscore.schema.json`；示例见两个曲谱文件。转换规则与可直接给AI的提示词见《给AI的转换提示词.txt》。2.7.1支持配置视觉AI后识别图片/PDF；不直接解析MIDI。识谱后的JSON仍须人工复核及校验。

你是曲谱转换器。把我提供的图片、PDF、MIDI内容或文字曲谱转换为TangScore v1。只返回一个纯JSON对象，不加Markdown代码围栏。不要编造看不清的音符，在warnings明确列出不确定的小节、声部或节奏；无法可靠辨认时请求更清晰来源，不输出虚假完整谱。
格式固定：format="tanglab.score"，version=1，title为1～64字符，tempo_bpm整数20～300，ticks_per_quarter=480，steps为1～2048个按演奏先后排序的对象。
每步：hand为left或right；midi为0～127整数（C4=60，C2=36，B5=83）；duration_ticks为1～30720整数；可选rest_before_ticks为0～30720整数。warnings可选字符串数组。禁止额外字段。
时值：四分音符480、八分240、十六分120、二分960、全音1920、附点四分720。连音延长应合并为一个音的总时值，休止写入下一步rest_before_ticks，不生成“休止音高”。拍号无需改变480基准。
首版是单手单音逐音等待，不支持同一步和弦或同时双手判题。和弦原谱必须提取明确主旋律，不把和弦拆成伪称同时演奏的连续步骤；在warnings说明省略的伴奏与和弦。双手交替可分别标注，遇同时声部选主旋律并警告。
正确处理谱号、调号、临时升降、八度记号；先保留原始实际MIDI音高。不要自行把半音改成自然音，不要擅自八度折叠。上位机会预览整曲八度移调/逐音八度折叠，由人确认后上传。超2048步应询问拆分段落，不静默截断。速度不明需在warnings标注采用的假设。
示例：{"format":"tanglab.score","version":1,"title":"两音练习","tempo_bpm":90,"ticks_per_quarter":480,"steps":[{"hand":"right","midi":60,"duration_ticks":480},{"hand":"left","midi":62,"duration_ticks":240,"rest_before_ticks":240}],"warnings":[]}
模型输出必须通过同目录tangscore.schema.json校验；AI不能代替谱面人工复核。

## 音域与布局
教学可表达MIDI36～83（C2～B5）。优先整曲移调整数个八度；无法整体放入时，逐音折叠整数个八度。界面逐项显示，任何变化都必须确认。默认自然音用七区，半音用十二区；五区仅容纳C、D、E、G、A，不会把F或B改成邻音。

## 时值与休止
当前是逐音等待，不做节拍评分。duration_ticks按速度换算为按键保持ms，板端范围100～10000ms，超范围会在预览提示并要求确认；自然衰减和释音仍单独作用，不等于全程等响。rest_before_ticks保存在电脑曲谱和预览，仅供提示，不传入32位板内步骤、不计时等待或判题。首版不模拟自动播放。

## 内部上传格式
每步32位小端：[31:16]保持ms，[15:9]MIDI，[8]右手为1，[7:4]音区0起，[3:2]八度代码（0=C4,1=C5,2=C2,3=C3），[1:0]布局（0七音,1五音,2十二音）。CRC32采用zlib/IEEE reflected，对全部小端步骤字节计算。曲名、原音、警告、休止、速度保存在电脑，不写入板内步骤。

电脑保存原始文件，导出适配文件保留original_midi。板内双区存储仅保留当前曲目，断电丢失。上传完成后逐字读回校验，不会自动开始发声。
