Starr1y/FPGA/experiments/2026-10-29-GEST26-stable/fpga/BOARD_VALIDATION.md

# 实物验证

未执行。须用户综合布线、检查时序并烧录GEST26后：静音下采集60秒静止/转向，做20次下拍，保存角度记录、诊断CSV、原始记录。记录成功数/错击/报告间隔/掉线/复位及CRC变化；不把仿真当作实测。
