Starr1y/FPGA/experiments/2026-10-29-GEST26-stable/fpga/手势协议.md

# GEST24协议扩展

HELLO标识`DUO04-LIVE 2.1+GEST24`，保留2.1功能前缀。帧头/CRC/序号/时间戳不变。

| 命令 | 负载 | 限制 |
|---|---|---|
| 0x40(64) | enabled_mask:uint8,invert_mask:uint8 | 两位掩码，停止时配置 |
| 0x41(65) | hand:uint8,pressed:uint8,pitch_q4:int16 LE | 仅电脑演奏，俯仰±90°；姿态40ms新鲜度、按键10ms消抖 |

状态0x88格式8、288字节；前256字节含义保留。新增256/257开关/反向位，258/259按住/新鲜位，260/261左右C档/历史档（每手2位，0C4/1C5/2C2/3C3），262..265为左右int16音分，266..269左右uint16组序号（仅显示，可回绕），270..273左右int16 Q4俯仰，274..277板上tick，余下保留。

0x89采样元数据版本2共48字节，前16字节结构兼容，仅格式字节为2；尾部32字节在板上开始采样时锁存，布局与状态256..287相同。主机等待五路、预期声部和元数据齐全才完成采样。记录回放支持格式1和2。

语义入口`gesture.configure`、`gesture.test`复用原认证API和命令队列。test的应答只是输入接受，状态需等待消抖/滤波；单次test不会保证持续发声。连续更新用常驻客户端20ms一次，同手尚未执行的更新合并为最新值。旧固件按能力拒绝新增操作。

菜单字段29/30为左右手势开关，31/32为左右方向反转，停止时生效；原字段保留。教学期间禁用手势，但保存设置。
