Starr1y/FPGA/experiments/2026-10-29-GEST26-stable/fpga/手势稳定协议.md

# GEST26稳定性与快速事件协议

HELLO `DUO04-LIVE 2.1+GEST26`。保持帧头/版本1、长度、序号、时间戳、CRC16；新上位机声明`gesture_stable26`能力。
状态0x88版本10，496字节。原0..495字段位置保持；286为两手yaw反向位。每手96字节诊断块中的74..95改为扩展，74=2。

|手诊断偏移|格式|含义|
|---|---|---|
|75|u8|bit0当前成对快照有效、bit1转向反向|
|76|u16|过去1秒线性加速度收到报告数|
|78|u32|最近两份线性报告间隔，100us ticks|
|82|u8|低4位快照音区；bit5:4八度码；bit7:6布局|
|83|u8|当前候选音区|
|84|u32|当前快照姿态时间，100us ticks|
|88|u32|最近接受下拍的线性加速度时间，100us ticks|
|92|i16|选区过滤航向，度×16|
|94|u8|当前要求成对快照但缺失|
|95|u8|保留|

字节82是下一次线性报告查找的当前快照；最近真实击发以0x8C事件为准。0/1/2/3八度码对应C4/C5/C2/C3，音区0起。

## 新命令
0x44(68)，payload `[hand u8, invert u8]`。hand=0/1、invert=0/1；演奏中拒绝。改变后取消该手旧事件、重新归中；断电不保存。
Agent：`diagnostic.direction {"hand":0,"invert":true}`。GUI/API统一串口队列，成功要求ACK及方向状态读回。原gesture.configure的invert仍仅表示俯仰反向。

## 快速击发事件0x8C(140)
固定32字节，小端：0版本=1，1手，2锁存音区，3锁存八度码，4布局，5力度，6触发原因，7 bit0=使用成对历史。
8计数u32；12核心计数器时间u32(50MHz)；16本手线性报告时间u32(100us)；20本手快照姿态时间u32(100us)；24快速事件覆盖计数u32；28..31保留。
使用历史时：(线性时间−快照时间)按u32模减应为300..800，即30..80ms。教学/旧手势事件bit0=0，不解释此差值。两个时间域不能直接相减求总延迟。
每手一个有界待发邮箱；两手同时到达均保留。ACK优先，然后事件，再状态/采样。正在发送的帧完整结束后再调度，不截断帧。若邮箱被覆盖，覆盖计数增长；这不影响声音，但表示观测事件丢失。
报告序号与CRC仍按统一发送器维护。计数复位为0不作为新击发上传。

## 时序与历史
姿态200Hz、gyro200Hz、线性400Hz目标不变。姿态计算与线性快照扫描各有ready背压；不复制声部运算器。
只接纳时间戳递增且传输年龄<=20ms的姿态，线性报告年龄<=40ms；拒绝重复/旧姿态，处理溢出计数包含拒绝数。
每手32条姿态历史，保存新有效报告的时间、已稳定音区/八度/布局。线性报告到来后用32周期共享扫描，选最近且提前30..80ms的一条；不是组合32路优先链。
为完成扫描，线性判断延后35个50MHz周期(0.7us)，检测门限/100ms保护不变。失效清空历史，恢复须重新积累。

记录使用原raw.jsonl接收帧格式，回放同时解码状态和事件。CSV包含快照与最近事件元数据。旧GEST25仍解码版本9，禁用方向命令。
