Starr1y/FPGA/experiments/2026-10-29-GEST26-stable/fpga/手势诊断协议.md

> 历史GEST25兼容参考。当前GEST26以《手势稳定协议.md》为准。

# GEST25诊断协议
保持TangLab帧头/序号/时间戳/CRC不变。HELLO为DUO04-LIVE 2.1+GEST25，新增imu_diagnostic能力。
状态0x88版本9，长度496字节；前288字节兼容版本8。
288..479为两手各96字节；480为诊断版本1，481为输出静音，482..495为两手各7字节腕部候选状态。
每手：0..31原手状态；32..37姿态/加速度/角速度Hz各u16；38..41处理溢出u32；42..57四类报告年龄(姿态/加速度/角速度/线加速度)各u32，50MHz周期，0xffffffff未收到；58..59线加速度Z Q8；60..63序号缺失；64..67复位次数；68首次原因，69最近故障原因；70..71报文头；72采样输入电平；73已配置报告掩码。其余保留0。
腕部候选每手7字节：低6位稳定毫秒，随后2位候选八度码；24位有符号参考俯仰Q8；24位有符号滤波俯仰Q8。八度码0/1/2/3对应C4/C5/C2/C3。
命令0x43(67)，一个布尔字节：只静音最终DAC，不影响合成和采样。状态481确认。上电不静音，默认低音量8/256。
Agent沿用POST /api/v1/commands：diagnostic.query {}，diagnostic.mute {"muted":true}，diagnostic.center {"hand":0}，diagnostic.reset {"hand":0}。复位与归中请求ACK只表示接受，完成需后续状态。命令工具run用法兼容。
诊断事件时间为PC观察时间，非精确击发板上时间；报告间多事件仅合并计数。年龄跨串口延迟不冒充完整传感器延迟。
