Starr1y/FPGA/experiments/2026-10-29-GEST26-stable/fpga/时序优化第二轮说明.txt

历史GEST25时序优化记录，仅作参考。当前GEST26已冻结，用户已综合并自行布局布线；本版状态以README.md、BUILD_STATUS.json和验证记录.md为准。以下为旧记录，不代表当前任务尚未完成RTL。

2026-10-25 时序优化第二轮

核心仍为50MHz；PLL、CST/SDC均未改动，没有新增假路径/多周期例外。
1. 菜单编辑拆为快照和运算两个周期；饱和阈值直接写常量，去掉字段驱动的阈值加减；停止/返回取消未提交编辑，教学期间禁止项继续拦截。
2. 声部配置按固定声部下标本地判断频率/目标，手选择成为编译常量，去掉动态声部读多路器到pitch_start的长数据通路；握手周期不变。
3. XSim五组测试PASS：菜单编辑上下限/单次写/停止取消、按键编码器、全局停止、和弦分组及声部抢占、32声部音频。最大渲染674核心周期，未增加音频预算。
4. 本轮未启动高云综合布局布线，尚未确认剩余193个setup端点消除；PR1014仍待最终报告检查。现有21:18生成的.fs/报告属于改动前版本，不能验收本轮修改。

继续方法：打开tanglab_duo04_stable26.gprj，确认顶层top_duo04，重新Synthesize，再Place & Route。只重跑布线会继续使用旧网表。
上位机仍用2.5.1，不用替换EXE；串口协议和接线未变化。不自动烧录、不上传仓库。
