Starr1y/FPGA/experiments/2026-10-29-GEST26-stable/fpga/audio-preview/说明.txt

RTL数字输出，未经过DAC/功放。顺序：钢琴、马林巴、电钢琴、拨弦；每种约0.233秒（包含尾音等待），同力度/同增益，先原音再±600音分。仅用于数字正确性及比较，不是音箱实测，也不作为高保真听感验收。
