Starr1y/FPGA/experiments/2026-10-29-GEST26-stable/fpga/preview/ui23-4.png

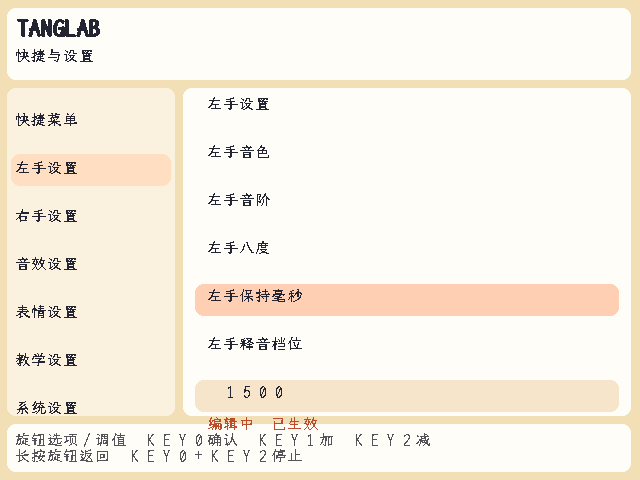
experiments/2026-10-29-GEST26-stable/fpga/preview/ui23-4.png
