Starr1y/FPGA/experiments/2026-10-29-GEST26-stable/fpga/preview/手势测试页.png

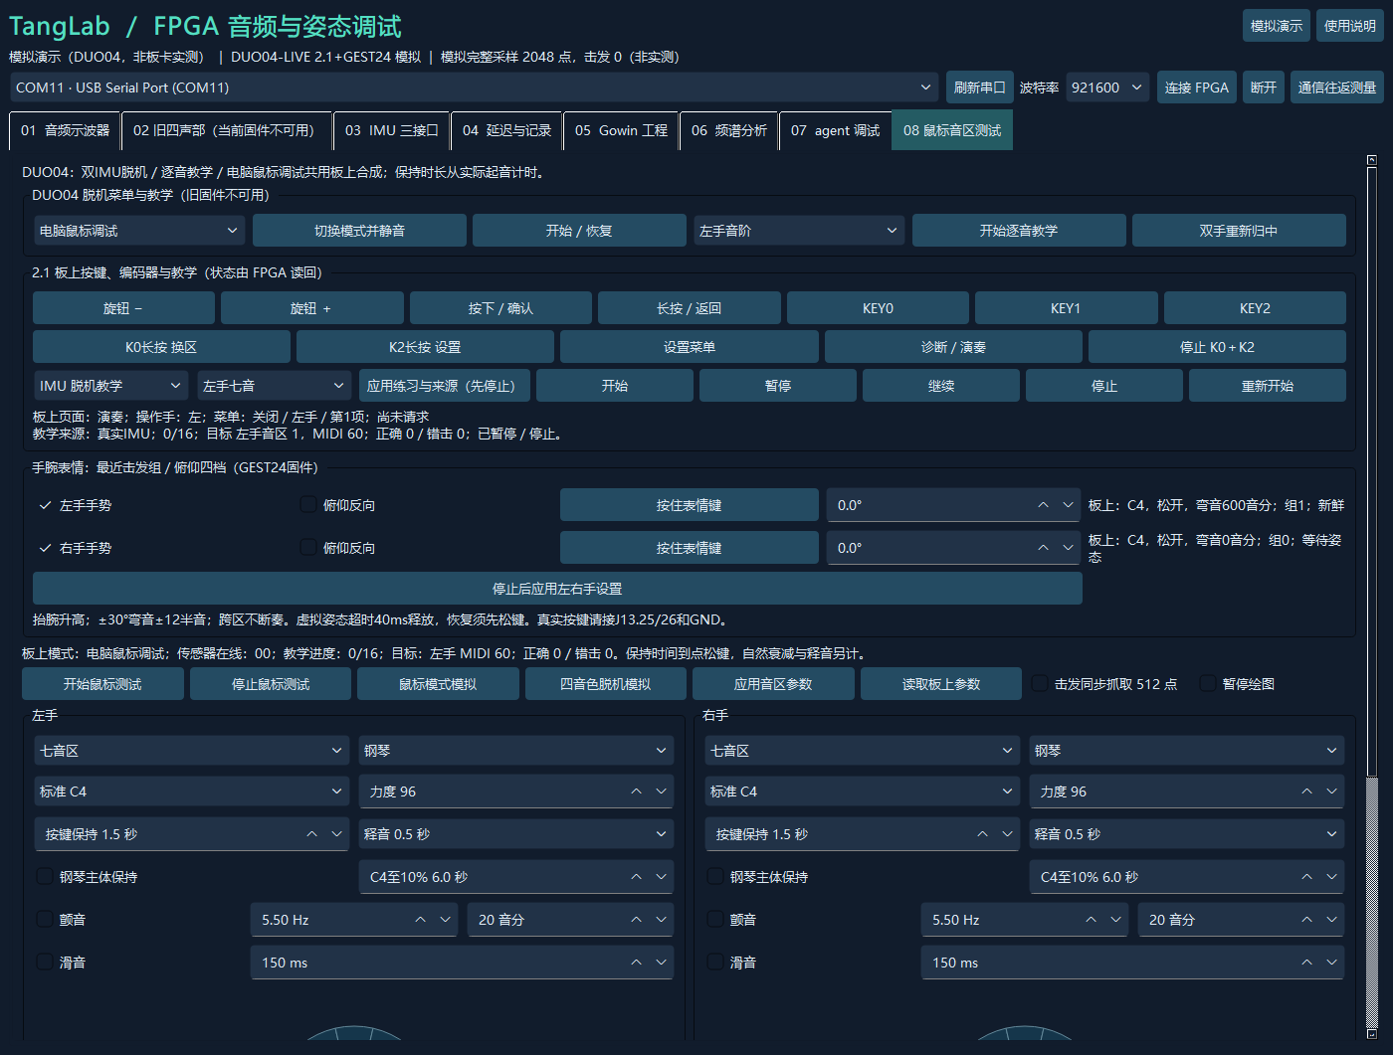
experiments/2026-10-29-GEST26-stable/fpga/preview/手势测试页.png
