Starr1y/FPGA/experiments/2026-10-29-GEST26-stable/fpga/validation/EXE诊断页.png

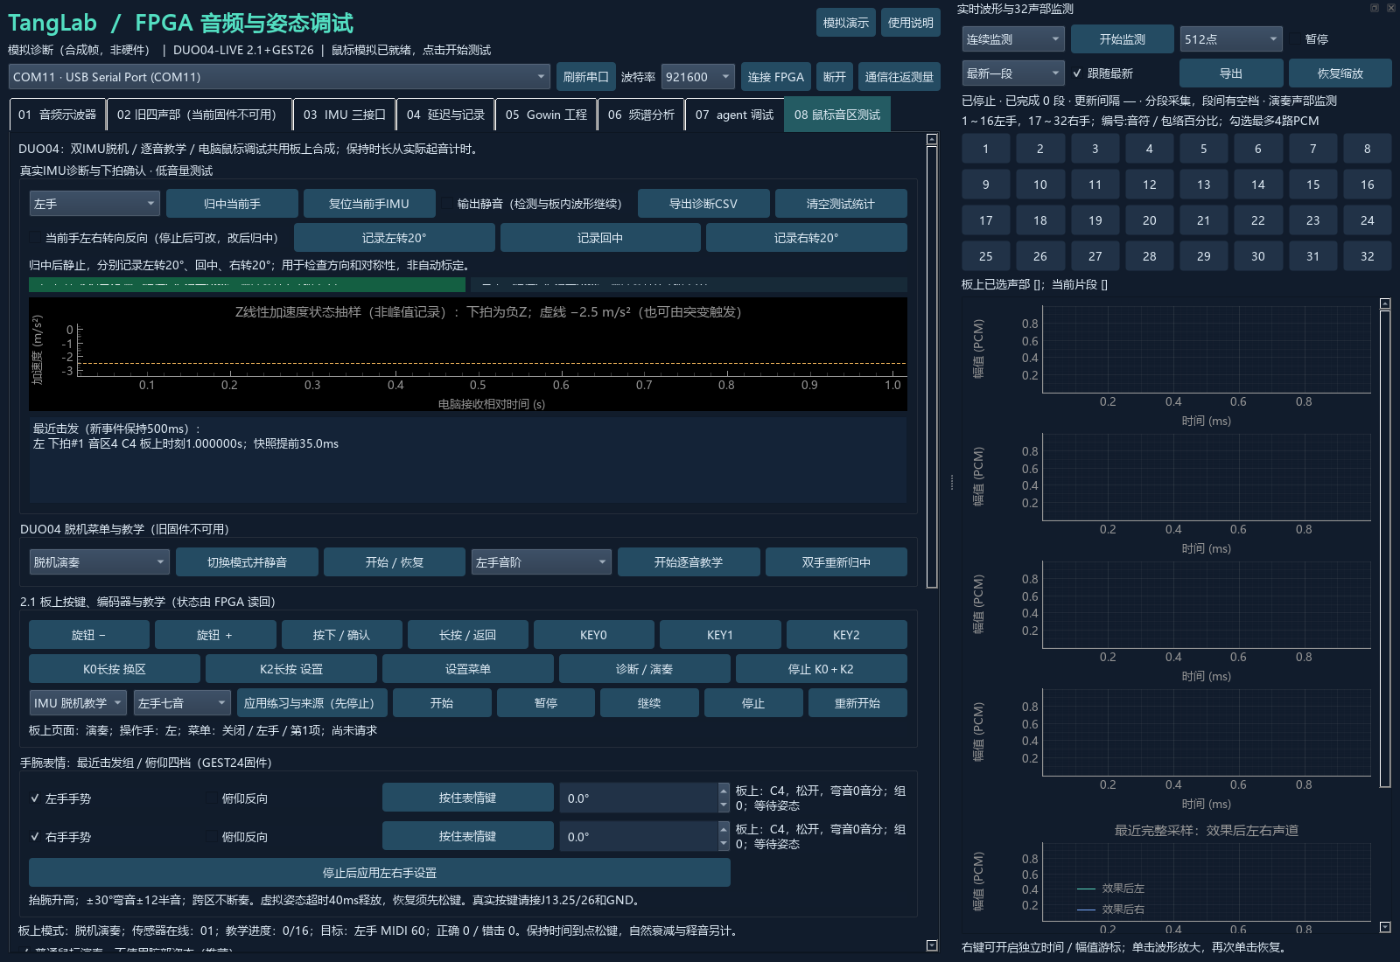
experiments/2026-10-29-GEST26-stable/fpga/validation/EXE诊断页.png
