Starr1y/FPGA/fpga/releases/2026-11-04-mpu33-host335/host/validation/exe/双模式演奏页.png

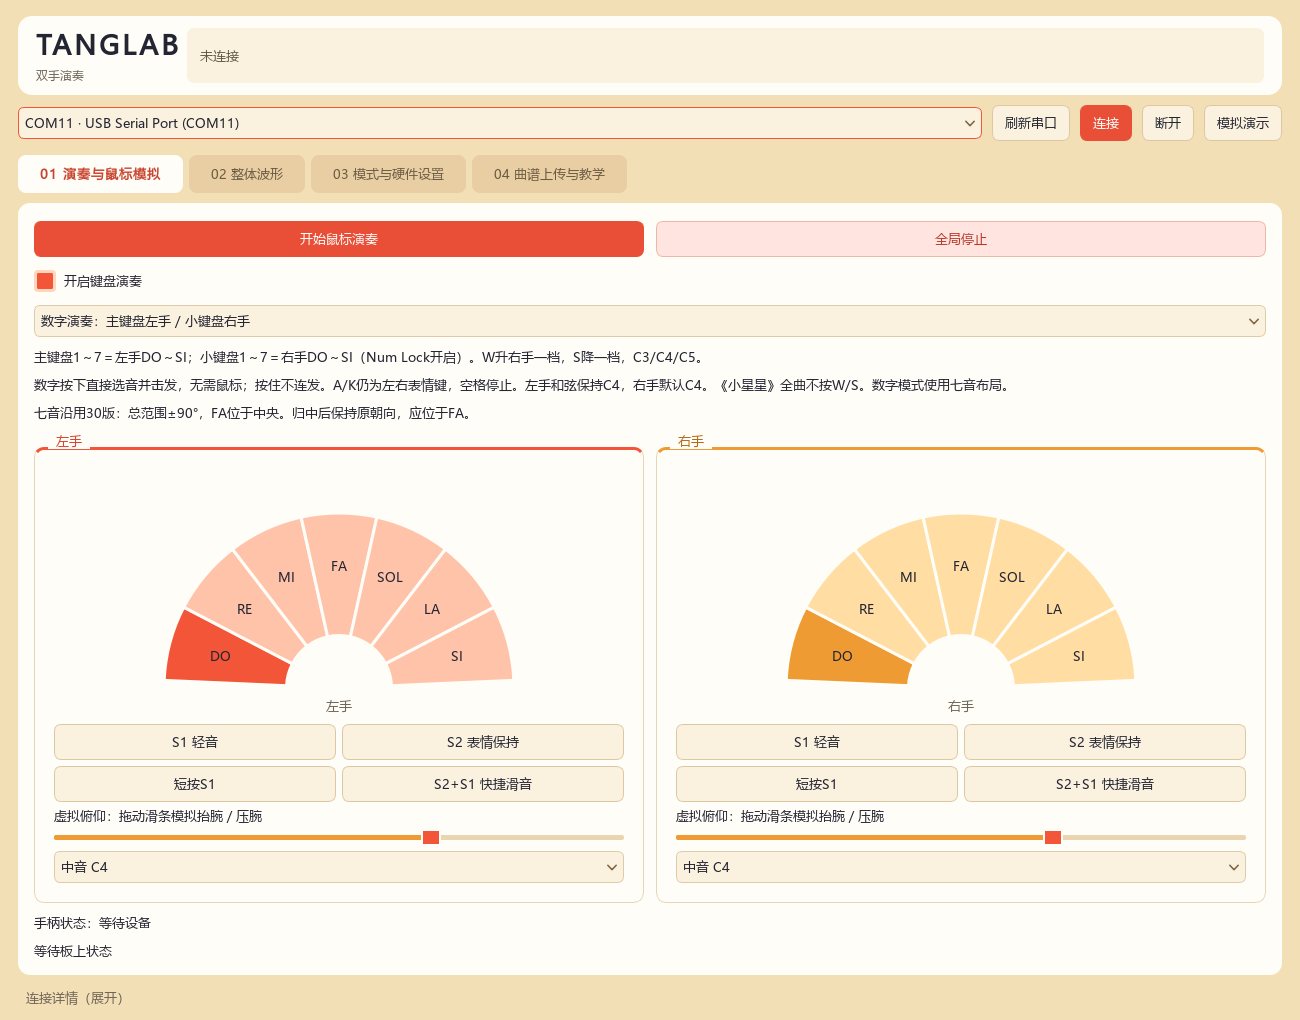
fpga/releases/2026-11-04-mpu33-host335/host/validation/exe/双模式演奏页.png
