Starr1y/FPGA/fpga/releases/2026-11-04-mpu33-host335/host/validation/source/教学数字映射页.png

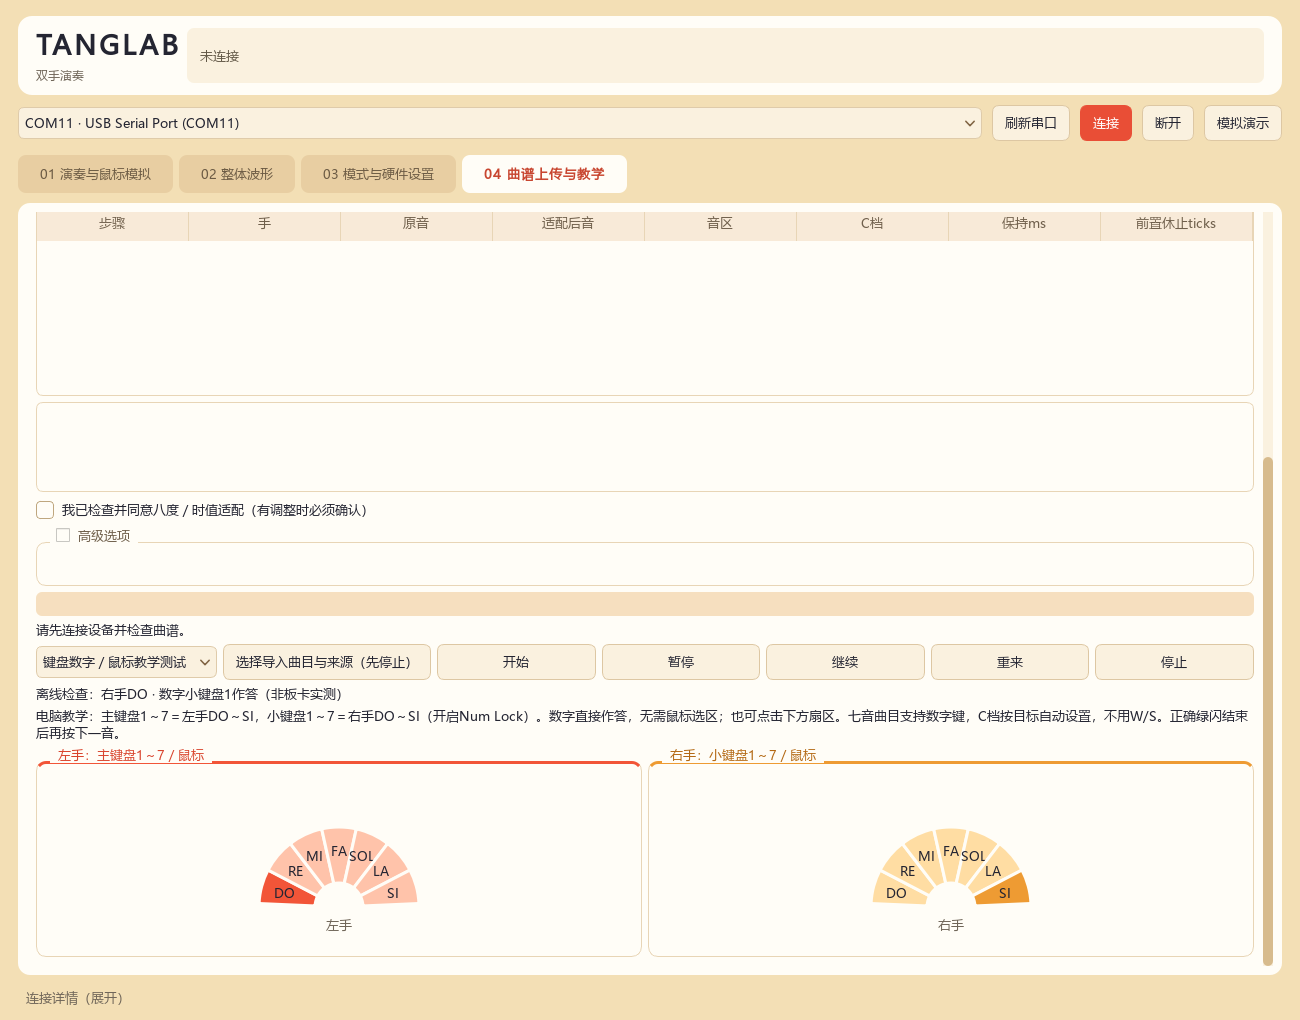
fpga/releases/2026-11-04-mpu33-host335/host/validation/source/教学数字映射页.png
