Starr1y/FPGA/fpga/current/tb/tb_score27_uart_fast.sv

`timescale 1ns/1ps
module tb_score27_uart_fast;
 reg[1:0]wrist_button_n=3;
 wire i2s_bck,i2s_ws,i2s_dout;
 reg clk=0;always #10 clk=~clk;
 reg encoder_a=1,encoder_b=1,encoder_button_n=1;
 reg reset_key=0,key0_n=1,key1_n=1,key2_n=1,pc_rx=1;
 tri[1:0]imu_scl,imu_sda,imu_rst_n;reg[1:0]imu_int_n=3;
 wire hp_bck,hp_ws,hp_din,pa_en,pc_tx,tmds_clk_p_0,tmds_clk_n_0;wire[2:0]tmds_d_p_0,tmds_d_n_0;
 // Packet gaps are shortened; sample rate, audio size, UART and FX RAM are production values.
 top_duo04 #(.BOOT_CYCLES(16),.KEY_DEBOUNCE(8),.CAPTURE_GAP_CYCLES(5000)) dut(.*);
 wire[7:0]byte_in;wire byte_valid;
 uart_rx listener(.clk(clk),.rst_n(dut.rst_n),.rx(pc_tx),.baud(32'd921600),.data(byte_in),.valid(byte_valid),.start(),.error());
 integer wirefile,parser=0,index=0,length=0,typ=0,completed_captures=0,offset,total,monitor_n=2;
 integer ack[0:255];reg[7:0]packet[0:4095];
 always @(posedge clk)if(byte_valid)begin
  if((^byte_in)===1'bx)$fatal(1,"unknown byte on UART");
  $fwrite(wirefile,"%02x ",byte_in);
  case(parser)
   0:if(byte_in==8'ha5)parser=1;
   1:if(byte_in==8'h5a)begin parser=2;index=0;end else parser=0;
   2:begin
    packet[index]=byte_in;
    if(index==1)typ=byte_in;
    if(index==2)length=byte_in;
    if(index==3)length=length+256*byte_in;
    if(index==length+11)begin
     if(typ==128 || typ==129 || typ==134)ack[packet[10]+256*packet[11]]=typ==128 ? 0 : packet[12];
     if(typ==139)monitor_n=packet[12];
     if(typ==138 || typ==130 && monitor_n==0)begin
      offset=packet[12]+256*packet[13];total=packet[14]+256*packet[15];
      if(offset+32==total)completed_captures++;
     end
     parser=0;
    end else index++;
   end
  endcase
 end
 function[15:0]crcbyte(input[15:0]crc,input[7:0]b);
  reg[15:0]v;integer n;begin v=crc^{b,8'b0};for(n=0;n<8;n++)v=v[15]?(v<<1)^16'h1021:v<<1;crcbyte=v;end
 endfunction
 task sendbyte(input[7:0]b);
  integer i;begin @(negedge clk);pc_rx=0;repeat(54)@(negedge clk);
   for(i=0;i<8;i++)begin pc_rx=b[i];repeat(54)@(negedge clk);end
   pc_rx=1;repeat(58)@(negedge clk);
  end
 endtask
 task command(input integer kind,n,seq,input[127:0]data,input integer expected);
  reg[15:0]crc;reg[7:0]b;integer i,timeout;
  begin
   sendbyte(8'ha5);sendbyte(8'h5a);crc=16'hffff;
   for(i=0;i<10+n;i++)begin
    case(i)0:b=1;1:b=kind;2:b=n;3:b=0;4:b=seq;5:b=0;6,7,8,9:b=0;default:b=data[(i-10)*8+:8];endcase
    sendbyte(b);crc=crcbyte(crc,b);
   end
   sendbyte(crc[7:0]);sendbyte(crc[15:8]);timeout=0;
   while(ack[seq]<0)begin @(negedge clk);timeout++;if(timeout>1000000)$fatal(1,"ACK timeout seq=%d",seq);end
   if(ack[seq]!=expected)$fatal(1,"ACK seq %d expected %d got %d",seq,expected,ack[seq]);
   $display("ACK_PASS command%0d sequence%0d code%0d",kind,seq,ack[seq]);
  end
 endtask
 task wait_capture(input integer n);
  integer timeout,k;reg[143:0]checksum_before,checksum_after;
  begin
   // Acquire all512 samples through the real audio/render path first. The
   // subsequent transport reads this immutable buffer; ongoing music is not
   // under test in this section (the independent32-voice bench covers it).
   wait(dut.cap_ready);
   if(dut.cap_active || dut.cap_points!=512)$fatal(1,"capture not complete");
   checksum_before=0;
   for(k=0;k<512;k=k+1)checksum_before=checksum_before+ dut.capture_mem[k];
   $display("CAPTURE_READY512; suspend only future audio samples while draining immutable capture");
   force dut.sample_tick=1'b0;
   timeout=0;
   while(completed_captures<n)begin @(negedge clk);timeout++;if(timeout>30000000)$fatal(1,"capture timeout");end
   checksum_after=0;
   for(k=0;k<512;k=k+1)checksum_after=checksum_after+ dut.capture_mem[k];
   if(checksum_after!==checksum_before)$fatal(1,"capture changed during transfer");
   release dut.sample_tick;
   $display("CAPTURE_TRANSFER_PASS512; audio sample enable restored");
  end
 endtask
 reg[127:0]data;integer i;
 initial begin
  for(i=0;i<256;i++)ack[i]=-1;
  wirefile=$fopen("score-wire-fast.hex","w");repeat(25)@(negedge clk);
  command(1,0,1,0,0);
  command(62,2,2,16'h0301,2); // no song loaded
  data=0;data[31:0]=123;data[39:32]=2;data[55:40]=2;data[87:56]=32'h1be29b71;
  command(69,11,3,data,0);
  data=0;data[31:0]=123;data[55:48]=2;data[87:56]=32'h01f4490a;data[119:88]=32'h01f49316;
  command(70,15,4,data,0);command(70,15,5,data,0);
  command(71,4,6,123,0);command(73,2,7,1,0);
  if(!dut.score_loaded || dut.score_readback!=32'h01f49316 || dut.running)$fatal(1,"UART commit/readback/start");
  command(62,2,8,16'h0301,0);command(63,1,9,1,0);
  repeat(30)@(negedge clk);
  if(!dut.running || dut.lesson_note!=36 || dut.lesson_octave!=2 || dut.profiles!=4'b1010)$fatal(1,"lesson configuration/auto C2");
  command(17,3,10,24'h020000,0);
  data=0;data[31:0]=101;data[39:32]=1;data[55:48]=2;data[71:64]=32;
  command(50,10,11,data,0);
  repeat(100)@(negedge clk);
  if(dut.lesson_correct!=1 || dut.lesson_position!=0 || dut.lesson_phase!=1)$fatal(1,"board judging failed");
  command(73,2,12,0,3); // readback during playing must not steal lesson RAM port
  wait_capture(1);
  command(63,1,13,2,0);repeat(30)@(negedge clk);
  if(dut.running)$fatal(1,"pause");
  command(63,1,14,3,0);command(51,0,15,0,0);
  if(dut.running)$fatal(1,"stop");
  $fclose(wirefile);$display("TB_PASS actual UART 1be29b71/ACK upload duplicate commit RAM readback/auto C2/board judging/capture512/pause/resume/stop");$finish;
 end
 initial begin #3000000000.0;$fatal(1,"watchdog");end
endmodule
