Starr1y/FPGA/fpga/releases/2026-11-04-mpu33-host335/project/duo04-key30-linkfix331/tb/reference/sine_lut_full_reference.v

// 1024-point signed sine, rounded; finer phase resolution than legacy 256 entries.
module sine_lut_full_reference(input [9:0] addr,output reg signed [15:0] value);
always @* case(addr)
10'd0:value=16'h0000;
10'd1:value=16'h00c9;
10'd2:value=16'h0192;
10'd3:value=16'h025b;
10'd4:value=16'h0324;
10'd5:value=16'h03ed;
10'd6:value=16'h04b6;
10'd7:value=16'h057f;
10'd8:value=16'h0648;
10'd9:value=16'h0711;
10'd10:value=16'h07d9;
10'd11:value=16'h08a2;
10'd12:value=16'h096a;
10'd13:value=16'h0a33;
10'd14:value=16'h0afb;
10'd15:value=16'h0bc4;
10'd16:value=16'h0c8c;
10'd17:value=16'h0d54;
10'd18:value=16'h0e1c;
10'd19:value=16'h0ee3;
10'd20:value=16'h0fab;
10'd21:value=16'h1072;
10'd22:value=16'h113a;
10'd23:value=16'h1201;
10'd24:value=16'h12c8;
10'd25:value=16'h138f;
10'd26:value=16'h1455;
10'd27:value=16'h151c;
10'd28:value=16'h15e2;
10'd29:value=16'h16a8;
10'd30:value=16'h176e;
10'd31:value=16'h1833;
10'd32:value=16'h18f9;
10'd33:value=16'h19be;
10'd34:value=16'h1a82;
10'd35:value=16'h1b47;
10'd36:value=16'h1c0b;
10'd37:value=16'h1ccf;
10'd38:value=16'h1d93;
10'd39:value=16'h1e57;
10'd40:value=16'h1f1a;
10'd41:value=16'h1fdd;
10'd42:value=16'h209f;
10'd43:value=16'h2161;
10'd44:value=16'h2223;
10'd45:value=16'h22e5;
10'd46:value=16'h23a6;
10'd47:value=16'h2467;
10'd48:value=16'h2528;
10'd49:value=16'h25e8;
10'd50:value=16'h26a8;
10'd51:value=16'h2767;
10'd52:value=16'h2826;
10'd53:value=16'h28e5;
10'd54:value=16'h29a3;
10'd55:value=16'h2a61;
10'd56:value=16'h2b1f;
10'd57:value=16'h2bdc;
10'd58:value=16'h2c99;
10'd59:value=16'h2d55;
10'd60:value=16'h2e11;
10'd61:value=16'h2ecc;
10'd62:value=16'h2f87;
10'd63:value=16'h3041;
10'd64:value=16'h30fb;
10'd65:value=16'h31b5;
10'd66:value=16'h326e;
10'd67:value=16'h3326;
10'd68:value=16'h33df;
10'd69:value=16'h3496;
10'd70:value=16'h354d;
10'd71:value=16'h3604;
10'd72:value=16'h36ba;
10'd73:value=16'h376f;
10'd74:value=16'h3824;
10'd75:value=16'h38d9;
10'd76:value=16'h398c;
10'd77:value=16'h3a40;
10'd78:value=16'h3af2;
10'd79:value=16'h3ba5;
10'd80:value=16'h3c56;
10'd81:value=16'h3d07;
10'd82:value=16'h3db8;
10'd83:value=16'h3e68;
10'd84:value=16'h3f17;
10'd85:value=16'h3fc5;
10'd86:value=16'h4073;
10'd87:value=16'h4121;
10'd88:value=16'h41ce;
10'd89:value=16'h427a;
10'd90:value=16'h4325;
10'd91:value=16'h43d0;
10'd92:value=16'h447a;
10'd93:value=16'h4524;
10'd94:value=16'h45cd;
10'd95:value=16'h4675;
10'd96:value=16'h471c;
10'd97:value=16'h47c3;
10'd98:value=16'h4869;
10'd99:value=16'h490f;
10'd100:value=16'h49b4;
10'd101:value=16'h4a58;
10'd102:value=16'h4afb;
10'd103:value=16'h4b9d;
10'd104:value=16'h4c3f;
10'd105:value=16'h4ce0;
10'd106:value=16'h4d81;
10'd107:value=16'h4e20;
10'd108:value=16'h4ebf;
10'd109:value=16'h4f5d;
10'd110:value=16'h4ffb;
10'd111:value=16'h5097;
10'd112:value=16'h5133;
10'd113:value=16'h51ce;
10'd114:value=16'h5268;
10'd115:value=16'h5302;
10'd116:value=16'h539b;
10'd117:value=16'h5432;
10'd118:value=16'h54c9;
10'd119:value=16'h5560;
10'd120:value=16'h55f5;
10'd121:value=16'h568a;
10'd122:value=16'h571d;
10'd123:value=16'h57b0;
10'd124:value=16'h5842;
10'd125:value=16'h58d3;
10'd126:value=16'h5964;
10'd127:value=16'h59f3;
10'd128:value=16'h5a82;
10'd129:value=16'h5b0f;
10'd130:value=16'h5b9c;
10'd131:value=16'h5c28;
10'd132:value=16'h5cb3;
10'd133:value=16'h5d3e;
10'd134:value=16'h5dc7;
10'd135:value=16'h5e4f;
10'd136:value=16'h5ed7;
10'd137:value=16'h5f5d;
10'd138:value=16'h5fe3;
10'd139:value=16'h6068;
10'd140:value=16'h60eb;
10'd141:value=16'h616e;
10'd142:value=16'h61f0;
10'd143:value=16'h6271;
10'd144:value=16'h62f1;
10'd145:value=16'h6370;
10'd146:value=16'h63ee;
10'd147:value=16'h646c;
10'd148:value=16'h64e8;
10'd149:value=16'h6563;
10'd150:value=16'h65dd;
10'd151:value=16'h6656;
10'd152:value=16'h66cf;
10'd153:value=16'h6746;
10'd154:value=16'h67bc;
10'd155:value=16'h6832;
10'd156:value=16'h68a6;
10'd157:value=16'h6919;
10'd158:value=16'h698b;
10'd159:value=16'h69fd;
10'd160:value=16'h6a6d;
10'd161:value=16'h6adc;
10'd162:value=16'h6b4a;
10'd163:value=16'h6bb7;
10'd164:value=16'h6c23;
10'd165:value=16'h6c8e;
10'd166:value=16'h6cf8;
10'd167:value=16'h6d61;
10'd168:value=16'h6dc9;
10'd169:value=16'h6e30;
10'd170:value=16'h6e96;
10'd171:value=16'h6efb;
10'd172:value=16'h6f5e;
10'd173:value=16'h6fc1;
10'd174:value=16'h7022;
10'd175:value=16'h7083;
10'd176:value=16'h70e2;
10'd177:value=16'h7140;
10'd178:value=16'h719d;
10'd179:value=16'h71f9;
10'd180:value=16'h7254;
10'd181:value=16'h72ae;
10'd182:value=16'h7307;
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
10'd984:value=16'he0e6;
10'd985:value=16'he1a9;
10'd986:value=16'he26d;
10'd987:value=16'he331;
10'd988:value=16'he3f5;
10'd989:value=16'he4b9;
10'd990:value=16'he57e;
10'd991:value=16'he642;
10'd992:value=16'he707;
10'd993:value=16'he7cd;
10'd994:value=16'he892;
10'd995:value=16'he958;
10'd996:value=16'hea1e;
10'd997:value=16'heae4;
10'd998:value=16'hebab;
10'd999:value=16'hec71;
10'd1000:value=16'hed38;
10'd1001:value=16'hedff;
10'd1002:value=16'heec6;
10'd1003:value=16'hef8e;
10'd1004:value=16'hf055;
10'd1005:value=16'hf11d;
10'd1006:value=16'hf1e4;
10'd1007:value=16'hf2ac;
10'd1008:value=16'hf374;
10'd1009:value=16'hf43c;
10'd1010:value=16'hf505;
10'd1011:value=16'hf5cd;
10'd1012:value=16'hf696;
10'd1013:value=16'hf75e;
10'd1014:value=16'hf827;
10'd1015:value=16'hf8ef;
10'd1016:value=16'hf9b8;
10'd1017:value=16'hfa81;
10'd1018:value=16'hfb4a;
10'd1019:value=16'hfc13;
10'd1020:value=16'hfcdc;
10'd1021:value=16'hfda5;
10'd1022:value=16'hfe6e;
10'd1023:value=16'hff37;
default:value=0;
endcase
endmodule
