Starr1y/FPGA/fpga/releases/2026-11-04-mpu33-host335/project/duo04-key30-linkfix331/tb/tb_pose_axes.sv

`timescale 1ns/1ps
module tb_pose_axes;
reg clk=0;always #5 clk=~clk;
reg rst_n=0,calibrate=0,quat_valid=0;reg signed[15:0]qx=0,qy=0,qz=0,qw=16384;
wire calibrated,calibrating,pose_valid;wire signed[15:0]yaw,pitch,roll;
integer failures=0,checks=0;
quaternion_pose #(.CLK_HZ(1000),.CAL_TIMEOUT_TICKS(200000)) dut(.clk(clk),.rst_n(rst_n),.sensor_restarted(1'b0),.online(1'b1),.calibrate(calibrate),.quat_valid(quat_valid),.qx(qx),.qy(qy),.qz(qz),.qw(qw),.accuracy(2'd3),.gx(16'd0),.gy(16'd0),.gz(16'd0),.quat_sequence(8'd0),.quat_timestamp_ticks(32'd0),.quat_timestamp_valid(1'b1),.calibrated(calibrated),.calibrating(calibrating),.pose_valid(pose_valid),.yaw(yaw),.pitch(pitch),.roll(roll));
task sample(input integer x,y,z,w);begin
 @(negedge clk);qx=x;qy=y;qz=z;qw=w;quat_valid=1;
 @(negedge clk);quat_valid=0;repeat(400)@(negedge clk);
end endtask
task cal(input integer x,y,z,w);begin
 @(negedge clk);calibrate=1;@(negedge clk);calibrate=0;
 repeat(52)sample(x,y,z,w);
 if(!calibrated)$fatal(1,"calibration failed");
end endtask
task check(input integer x,y,z,w,ey,ep,er);begin
 sample(x,y,z,w);checks=checks+1;
 if(yaw<ey-12 || yaw>ey+12 || pitch<ep-12 || pitch>ep+12 || roll<er-12 || roll>er+12)begin
 failures=failures+1;$display("FAIL q=%d,%d,%d,%d yaw=%d pitch=%d roll=%d expected=%d,%d,%d",x,y,z,w,yaw,pitch,roll,ey,ep,er);
 end
end endtask
initial begin repeat(5)@(negedge clk);rst_n=1;
cal(0,0,0,16384);
check(0,-8192,0,14189,0,-960,0);
check(0,8192,0,-14189,0,-960,0);
check(0,-4240,0,15826,0,-480,0);
check(0,4240,0,-15826,0,-480,0);
check(0,0,0,16384,0,0,0);
check(0,0,0,-16384,0,0,0);
check(0,4240,0,15826,0,480,0);
check(0,-4240,0,-15826,0,480,0);
check(0,8192,0,14189,0,960,0);
check(0,-8192,0,-14189,0,960,0);
check(0,0,-16383,143,-2864,0,0);
check(0,0,-11585,11585,-1440,0,0);
check(0,0,-6270,15137,-720,0,0);
check(0,0,-2845,16135,-320,0,0);
check(0,0,0,16384,0,0,0);
check(0,0,2845,16135,320,0,0);
check(0,0,6270,15137,720,0,0);
check(0,0,11585,11585,1440,0,0);
check(0,0,16383,143,2864,0,0);
check(-2399,-5793,-5793,13985,-720,-720,0);
check(2399,5793,-5793,13985,-720,720,0);
check(0,-6270,0,15137,0,-720,0);
check(0,6270,0,15137,0,720,0);
check(2399,-5793,5793,13985,720,-720,0);
check(-2399,5793,5793,13985,720,720,0);
cal(4240,0,0,15826);
check(3672,-7913,-2120,13705,0,-960,0);
check(-3672,7913,2120,-13705,0,-960,0);
check(4096,-4096,-1098,15286,0,-480,0);
check(-4096,4096,1098,-15286,0,-480,0);
check(4240,0,0,15826,0,0,0);
check(-4240,0,0,-15826,0,0,0);
check(4096,4096,1098,15286,0,480,0);
check(-4096,-4096,-1098,-15286,0,480,0);
check(3672,7913,2120,13705,0,960,0);
check(-3672,-7913,-2120,-13705,0,960,0);
check(37,4240,-15825,138,-2864,0,0);
check(2998,2998,-11190,11190,-1440,0,0);
check(3918,1623,-6056,14621,-720,0,0);
check(4176,736,-2748,15585,-320,0,0);
check(4240,0,0,15826,0,0,0);
check(4176,-736,2748,15585,320,0,0);
check(3918,-1623,6056,14621,720,0,0);
check(2998,-2998,11190,11190,1440,0,0);
check(37,-4240,15825,138,2864,0,0);
check(1302,-4096,-7094,14129,-720,-720,0);
check(5937,7094,-4096,12887,-720,720,0);
check(3918,-6056,-1623,14621,0,-720,0);
check(3918,6056,1623,14621,0,720,0);
check(5937,-7094,4096,12887,720,-720,0);
check(1302,4096,7094,14129,720,720,0);
cal(-4240,0,0,15826);
check(-3672,-7913,2120,13705,0,-960,0);
check(3672,7913,-2120,-13705,0,-960,0);
check(-4096,-4096,1098,15286,0,-480,0);
check(4096,4096,-1098,-15286,0,-480,0);
check(-4240,0,0,15826,0,0,0);
check(4240,0,0,-15826,0,0,0);
check(-4096,4096,-1098,15286,0,480,0);
check(4096,-4096,1098,-15286,0,480,0);
check(-3672,7913,-2120,13705,0,960,0);
check(3672,-7913,2120,-13705,0,960,0);
check(-37,-4240,-15825,138,-2864,0,0);
check(-2998,-2998,-11190,11190,-1440,0,0);
check(-3918,-1623,-6056,14621,-720,0,0);
check(-4176,-736,-2748,15585,-320,0,0);
check(-4240,0,0,15826,0,0,0);
check(-4176,736,2748,15585,320,0,0);
check(-3918,1623,6056,14621,720,0,0);
check(-2998,2998,11190,11190,1440,0,0);
check(-37,4240,15825,138,2864,0,0);
check(-5937,-7094,-4096,12887,-720,-720,0);
check(-1302,4096,-7094,14129,-720,720,0);
check(-3918,-6056,1623,14621,0,-720,0);
check(-3918,6056,-1623,14621,0,720,0);
check(-1302,-4096,7094,14129,720,-720,0);
check(-5937,7094,4096,12887,720,720,0);
cal(0,0,6270,15137);
check(3135,-7568,5430,13109,0,-960,0);
check(-3135,7568,-5430,-13109,0,-960,0);
check(1623,-3918,6056,14621,0,-480,0);
check(-1623,3918,-6056,-14621,0,-480,0);
check(0,0,6270,15137,0,0,0);
check(0,0,-6270,-15137,0,0,0);
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
check(-4096,-5937,-14129,4096,0,-720,0);
check(7094,-1302,-12887,7094,0,720,0);
check(-4282,-8200,-10339,8716,720,-720,0);
check(4282,365,-10339,11961,720,720,0);
cal(-1623,3918,-14621,6056);
check(-8716,365,-11851,7204,0,-960,0);
check(8716,-365,11851,-7204,0,-960,0);
check(-5352,2217,-13703,6864,0,-480,0);
check(5352,-2217,13703,-6864,0,-480,0);
check(-1623,3918,-14621,6056,0,0,0);
check(1623,-3918,14621,-6056,0,0,0);
check(2217,5352,-14543,4836,0,480,0);
check(-2217,-5352,14543,-4836,0,480,0);
check(5905,6421,-13474,3286,0,960,0);
check(-5905,-6421,13474,-3286,0,960,0);
check(-3932,-1589,-6184,-14568,-2864,0,0);
check(-3918,1623,-14621,-6056,-1440,0,0);
check(-2998,2998,-15826,0,-720,0,0);
check(-2278,3576,-15451,3425,-320,0,0);
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
