Starr1y/FPGA/(commit log)

2026-10-10 Add STM32 BNO085 Python validation dashboard
2026-10-11 Publish FAN03 FPGA HDMI and negative-Z gesture firmware; exclude host apps
    [负Z动作实测.csv]
2026-10-11 Publish FAN04 pose-timed expression filters and FPGA validation
2026-10-11 Add independent dual-hand I2C core and event ownership validation
2026-10-17 Add DUO03 unified control candidate and physical latency audit tools
    [latency.csv]
2026-10-17 Add passive stereo FFT and atomic audio observation frames
2026-10-18 Add latest UI21 FPGA candidate with standard I2S and mixed IMU rates
2026-10-18 Add pin verification and current I/O validation evidence
2026-10-19 Document IO22 board validation and current controls
2026-10-20 Freeze verified IO22 I2S and mixed-rate IMU implementation
2026-11-02 Publish frozen V14 MPU selection release and archive superseded versions
    Preserve the GEST26 baseline and existing host 2.7.2 archive. Add portable verification, six replayed regressions, a 180-second filming script and an evidence-based task audit. Keep audio and orientation issues explicit; dual-MPU and volume 80 belong to the next build.
    [latency.csv, 负Z动作实测.csv]
2026-11-04 Archive dual-MPU L331 firmware and TangLab 3.3.5 portable and sources
    Add an independent release snapshot, matched source and bitstream hashes, original implementation reports, host rebuild entry and complete portable archive. Preserve V14/current and historical host files. Record existing setup violations and PR1014 without claiming timing closure.
